digunderground/titan-bridge/hardware/ESP32 S3 N16R8 DevKitC-1 Module, for ESP32 S3 Development Boards with WiFi, Bluetooth 5.0 for Arduino, USB C with Antenna + IPEX.png

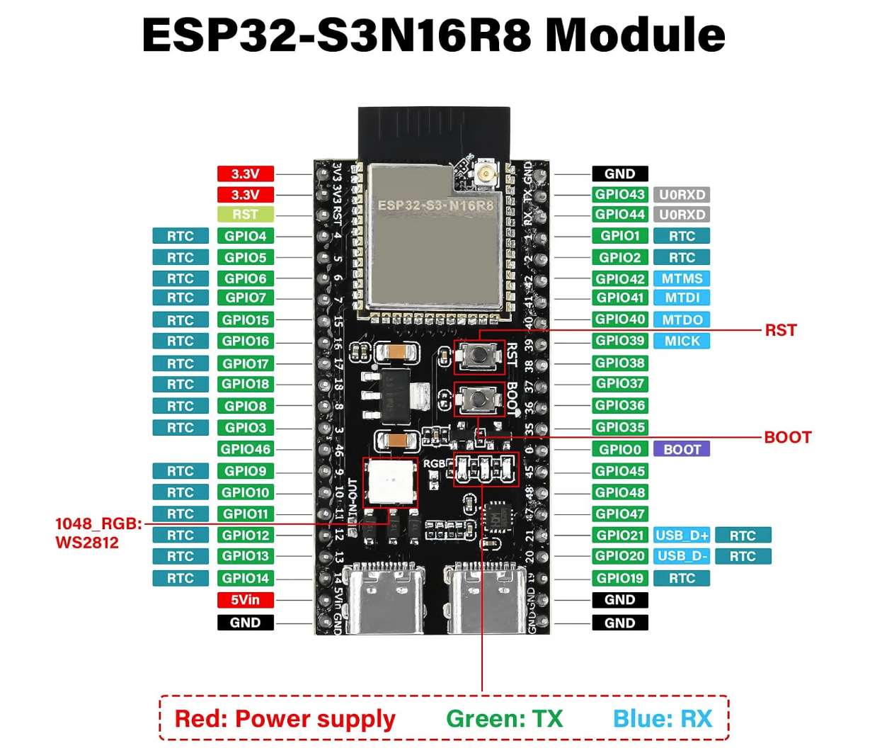
hardware/ESP32 S3 N16R8 DevKitC-1 Module, for ESP32 S3 Development Boards with WiFi, Bluetooth 5.0 for Arduino, USB C with Antenna + IPEX.png
