digunderground/titan-bridge/docs/06-command-reference.md

# XGIMI TITAN Noir — verified command reference

Transcribed from XGIMI's own command-set image (help centre article
`53406154382361`, attachment `53406327353497`, 2110×1253) and checked
byte-for-byte against the checksum rule. Where the source document is
internally inconsistent, that is called out rather than silently corrected.

## Link settings

| | |
|---|---|
| Enable | Settings → General → **Serial Port Control** = ON |
| Transport | USB-to-RS232 or USB-to-TTL adapter in a projector USB port |
| Baud | 115200 |
| Frame | 8 data bits, no parity, 1 stop bit |
| Flow control | none |

Both projector USB ports (one 3.0, one 2.0) are documented as accepting a
USB-to-RS232 adapter, which is what makes the two-channel architecture
possible.

## Acknowledgements — undocumented, measured 2026-09-05

XGIMI's command image shows no acknowledgement. The projector sends one for
every command it accepts:

```
2A 2A 02 <instruction | 0x80> <parameter echoed> <checksum>
```

```
TX 2A 2A 02 03 1B 20   filmmaker      ->  RX 2A 2A 02 83 1B A0
TX 2A 2A 02 05 07 0E   brightness 7   ->  RX 2A 2A 02 85 07 8E
TX 2A 2A 02 13 00 15   temp           ->  RX 2A 2A 02 93 00 95
```

**The ACK does not indicate support.** It was tempting to read it as one — an
unsupported command producing no ACK would make the undocumented parameter
space testable without watching the screen. It does not work: sweeping
instruction `0x01` produced an ACK for **every** parameter tried, including
`0x7F`, `0x80`, `0xC0` and `0xFE`, none of which can be real inputs.

So the ACK confirms the frame was received and parsed, and nothing more. It is
still useful — it proves the link is alive and that a command was well-formed —
but the only way to know whether a parameter *does* something remains watching
the screen.

A status postback (e.g. temperature) arrives **six times, ~50 ms apart**, after
the ACK.

## Key simulation — instruction 0x07, undocumented parameters

Swept one code at a time with visual confirmation, 2026-09-05. XGIMI documents
`0x08`-`0x15`; the range below it was unexplored.

| Param | Effect |
|---|---|
| `0x01`-`0x05`, `0x07` | acknowledged, **no visible effect** |
| **`0x06`** | **opens a black-and-white calibration / test pattern** |

`0x06` is a genuine find: a service screen with no button on the remote and no
mention in XGIMI's table. It exits with `back`.

**The remote's four shortcut keys are not in this range**, and may not be
exposed over serial at all. Assignable buttons backed by recorded macros are a
better route to the same outcome — more than four of them, with labels.

Sweeping further (`0x16`+) was deliberately stopped: the codes are sparse, and
the odds of finding another service screen outweigh the value of finding
another key. If it is ever resumed, do it **one code at a time with the screen
in view** — a seven-code batch identified only that "something in this range
does something", which is barely a result.

Note this also confirms, on a second instruction, that **an ACK says nothing
about whether a code is live**. Six of these acknowledged and did nothing.

## Frame format

```
2A 2A <length> <instruction> <parameters...> <checksum>

length   = 1 (the instruction byte) + number of parameter bytes
checksum = (length + instruction + all parameter bytes) & 0xFF
```

The header `2A 2A` is excluded from the checksum. Worked examples from XGIMI's
own table: HDMI1 is `2A2A 02 01 01 04` (0x02+0x01+0x01 = 0x04); standby wake is
`2A2A 07 09 77 61 6B 65 75 70 9D`, where the parameters spell `wakeup` in ASCII
and the bytes sum to 0x29D → 0x9D.

---

## Source select — instruction 0x01

| Function | Param | Full frame | Firmware name |
|---|---|---|---|
| HDMI1 | 01 | `2A2A 02 01 01 04` | `hdmi1` |
| HDMI2 | 02 | `2A2A 02 01 02 05` | `hdmi2` |
| USB | 14 | `2A2A 02 01 14 17` | `usbsrc` |
| HDMI3 — **not in the document, CONFIRMED REAL 2026-09-05** | 03 | `2A2A 02 01 03 06` | `hdmi3` |

The published table lists two HDMI inputs on a three-HDMI projector, which
suggests it was copied from the original two-input TITAN. `hdmi3` is included
in the firmware on that suspicion. Day 1 Test 4 settles it; if `03` does
nothing, `sweep 01 00 08` walks the whole space.

## Picture mode — instruction 0x03

**Measured 2026-09-06. Five of the seven documented modes do nothing.**

| Mode | Param | Frame | Name | Effect on this unit |
|---|---|---|---|---|
| Vivid | 00 | `2A2A 02 03 00 05` | `vivid` | **none** |
| Movie | 01 | `2A2A 02 03 01 06` | `movie` | **none** |
| IMAX Enhanced | 02 | `2A2A 02 03 02 07` | `imax` | **none** |
| Performance | 05 | `2A2A 02 03 05 0A` | `perf` | works |
| TV | 07 | `2A2A 02 03 07 0C` | `tvmode` | **none** |
| Sport | 09 | `2A2A 02 03 09 0E` | `sport` | **none** |
| Filmmaker | 1B | `2A2A 02 03 1B 20` | `filmmaker` | works |

Parameters 03, 04, 06, 08 and 0A–1A are undocumented and were swept: all ACK,
none change the mode.

Three things this establishes, none of them in the vendor document:

1. **Only `05` and `1B` do anything.** Every other parameter, documented or
   not, is accepted and discarded.
2. **The ACK proves receipt, not support and not effect.** A documented mode
   like `00` ACKs perfectly and leaves the picture untouched. This is the
   second independent refutation of "no ACK means unsupported" — that claim was
   already retracted once, and the converse fails too.
3. **Performance and Filmmaker are not in the on-screen mode list.** The remote
   offers Standard, Movie, Sports, ISF Day, ISF Night. So the serial parameters
   and the OSD are two different sets, and `05`/`1B` reach modes the remote
   cannot. There is no serial parameter for Standard.

Picture mode is **write-only**: changing it from the physical remote produces
no serial frame at all (verified over a full five-mode walk — the projector
sent nothing but its 10-second temperature poll), so the current mode cannot be
read back.

## Brightness — instruction 0x05

Levels 1–10 are parameters `01`–`0A`, checksums `08`–`11`.

| Level | Frame | Name |
|---|---|---|
| 1 | `2A2A 02 05 01 08` | `b1` |
| 5 | `2A2A 02 05 05 0C` | `b5` |
| 10 | `2A2A 02 05 0A 11` | `b10` |

There is **no brightness query**. The bridge's step-up/step-down keys track
their own index open-loop and resynchronise whenever an explicit `b1`–`b10` is
sent.

## Factory reset — instruction 0x06  ⚠

| Function | Param | Frame |
|---|---|---|
| Restore factory settings, **wiping apps** | 00 | `2A2A 02 06 00 08` |
| Restore factory settings, keeping apps | 01 | `2A2A 02 06 01 09` |

Neither is reachable by name in either firmware, and `sweep` refuses
instruction `06` outright. Send it by hand with `raw` if you ever actually
mean it.

## Simulated key press — instruction 0x07

This is the way into everything the serial set does not cover: it drives the
OSD blind. See `docs/05-menu-mapping-worksheet.md`.

| Key | Param | Frame | Name |
|---|---|---|---|
| Power | 00 | `2A2A 02 07 00 09` | `power` |
| Signal source / custom | 08 | `2A2A 02 07 08 11` | `source` |
| Up | 09 | `2A2A 02 07 09 12` | `up` |
| Down | 0A | `2A2A 02 07 0A 13` | `down` |
| Right | 0B | `2A2A 02 07 0B 14` | `right` |
| Left | 0C | `2A2A 02 07 0C 15` | `left` |
| OK | 0D | `2A2A 02 07 0D 16` | `ok` |
| Back | 0E | `2A2A 02 07 0E 17` | `back` |
| Setting | 0F | `2A2A 02 07 0F 18` | `setting` |
| Home | 10 | `2A2A 02 07 10 19` | `home` |
| Volume up | 11 | `2A2A 02 07 11 1A` | `volup` |
| Volume down | 12 | `2A2A 02 07 12 1B` | `voldn` |
| Auto focus | 13 | `2A2A 02 07 13 1C` | `autofocus` |
| Manual focus | 14 | `2A2A 02 07 14 1D` | `manfocus` |
| Mute | 15 | `2A2A 02 07 15 1E` | `mute` |

The **power key is a toggle, not a discrete off.** Measured 2026-09-06: it
raises a **15-second power-off countdown**, and that countdown **completes into
a shutdown on its own**. `OK` only short-circuits it.

**The power key is sometimes not acknowledged at all**, while an `OK` sent
900 ms later on the same wire is acknowledged in 16 ms — so it is the projector
refusing that specific frame, not a sick link. When that happens the key has
provably had no effect: the `OK` then confirms nothing and the projector stays
on. That is what makes resending it safe — there is no countdown standing that a
second press could cancel.

Power-off therefore **waits for the power key's own ACK** before sending `OK`,
resends the power key up to 3 times if the ACK does not arrive, and gives up
without sending `OK` rather than confirming a dialog that was never raised.

Two earlier attempts are recorded here as warnings. Waiting out the 15 s
countdown instead of confirming was deterministic but slower, and dropping a
`back` keypress in front of the power key — on a correlation from seven samples —
took power-off from intermittent to failing 10/10. Both replaced a working
sequence without measuring against it.

Because the key is a toggle, sending it to an **already-off** projector turns it
**on**. That is why a hub's "Power off" button could wake the unit. The bridge
now guards off in both power modes while never guarding on — `wake` is
idempotent, so guarding it only creates a "PowerOn does nothing" failure.

There is **no Menu key** here. The USB HID keyboard's Application/Menu key
(usage `0x65`) has no serial equivalent, which is the whole reason the HID
channel stays in the final design.

## Standby wake — instruction 0x09

```
2A2A 07 09 77 61 6B 65 75 70 9D          parameters = "wakeup" in ASCII
```

Conspicuously not a simulated key press. An ASCII payload on its own
instruction suggests a separate always-listening path in the projector's
firmware — which is exactly what you would want a wake command to be.

**`wake` is idempotent.** Sent to a projector that is already on, it does
nothing at all (measured 2026-09-06). This is what makes it safe to send
unconditionally, and it is why the on-path is never guarded.

### There is no discrete off — probed and ruled out

Because `0x09` is *string-keyed*, a symmetric off seemed plausible. Each of
these was sent to an awake projector:

| word | frame | result |
|---|---|---|
| `sleep` | `2A2A 06 09 73 6C 65 65 70 28` | ACK, no effect |
| `standby`  | `2A2A 08 09 73 74 61 6E 64 62 79 06` | ACK, no effect |
| `poweroff` | `2A2A 09 09 70 6F 77 65 72 6F 66 66 7A` | ACK, no effect |
| `shutdown` | `2A2A 09 09 73 68 75 74 64 6F 77 6E 8E` | ACK, no effect |

All four were acknowledged with the **payload echoed back verbatim** —
byte-for-byte the same ACK shape as the working `wakeup`. So for this
instruction the echo carries no signal whatsoever: a command that works and
four that do nothing are indistinguishable in the reply.

That matters beyond power. Echo inspection looked like the most promising way
to enumerate real commands without a camera (the UDS `requestOutOfRange`
trick). On `0x09` it does not work. Anything built on it must be validated
against a known-good/known-dead pair first.

## Screen blank — instruction 0x0D

| Function | Param | Frame | Name |
|---|---|---|---|
| Turn off the screen | 00 | `2A2A 02 0D 00 0F` | `blank` |
| Open screen | 01 | `2A2A 02 0D 01 10` | `unblank` |

## High refresh rate — instruction 0x0E

| Function | Param | Checksum in doc | Frame used | Name |
|---|---|---|---|---|
| Off | 00 | 10 | `2A2A 02 0E 00 10` | `hrroff` |
| Basics | 01 | 11 | `2A2A 02 0E 01 11` | `hrrbasic` |
| Extreme speed | **01** | **12** | `2A2A 02 0E 02 12` | `hrrmax` |

The document prints parameter `01` twice with two different checksums. `0x12`
is only reachable if the parameter is `02` (0x02+0x0E+0x02), and a distinct
mode needs a distinct parameter. **The firmware follows the checksum.** Verify
on hardware and, if `02` does nothing, try `raw 2A2A020E0111` and watch whether
the mode differs from `hrrbasic`.

## Temperature — instruction 0x13

Request:

```
2A2A 02 13 00 15                          firmware name: temp
```

Postbacks arrive **unprompted** as well as in reply:

| Meaning | Frame |
|---|---|
| Normal | `2A2A 03 13 01 00 17` |
| High temperature warning | `2A2A 03 13 01 01 18` |
| High temperature shutdown warning | `2A2A 03 13 01 02 19` |
| Low temperature shutdown warning | `2A2A 03 13 01 03 1A` |
| Sensor abnormal (open/short circuit) | `2A2A 03 13 01 04 1B` |

**This is the only feedback channel the projector has** — and it does not
report power state. The projector's serial daemon runs in standby and answers
the temperature probe identically either way, so a reply means the *link* is
alive, not that the projector is on. An earlier version of this document said
the opposite; that was wrong, and `TEMP_PROBE_INDICATES_POWER 0` in `config.h`
encodes the correction. Power state is assumed and user-correctable, because
nothing on the wire can confirm it.

`0x13` is **not** a general query family. Parameters `01`–`20` were swept
2026-09-06: every one is ACKed, none returns a data frame. `00` is the only
parameter that answers. There is no readback for input, picture mode, volume
or power — the protocol is write-only apart from temperature.

Log the postbacks — a high-temperature warning is the one thing here worth an
alert.

---

## USB keyboard map (HID channel)

XGIMI documents a USB keyboard as a supported input device. These are the
usages the bridge sends.

| Key | HID usage | Function | Serial equivalent |
|---|---|---|---|
| Arrows | 0x4F–0x52 | Navigation | yes |
| Enter | 0x28 | OK | yes |
| Esc | 0x29 | Back | yes |
| Home | 0x4A | Open settings | yes |
| Page Up / Down | 0x4B / 0x4E | Volume | yes |
| Keypad + / − | 0x57 / 0x56 | Manual focus | partial (`manfocus` only) |
| **Menu / Application** | **0x65** | Contextual menu | **no** |

## TITAN IR codeset (NEC, header 0x21DE)

Published for the **original** TITAN. The Noir series dropped the rear IR
receiver, the 3.5 mm REMOTE port and the IR remote, so this is only relevant if
Day 1 Test 6 finds a live receiver anyway.

| Key | Code | Key | Code | Key | Code |
|---|---|---|---|---|---|
| Power | 4D | Home | 1A | Menu | 45 |
| Back | 42 | Source | 4F | Up | 0B |
| Down | 0E | Left | 10 | Right | 11 |
| OK | 0D | Settings | 48 | Settings (after OSD) | 12 |
| OSD | 19 | Vol+ | 18 | Vol− | 17 |
| Focus+ | 1C | Focus− | 1D | Menu rotation | 1E |
| Keystone | 1F | Lens shift & zoom | 20 | HDMI1 | 24 |
| HDMI2 | 25 | USB | 26 | Picture standard | 41 |
| Movie | 44 | Vivid | 4A | TV | 4B |

The p2 firmware **receives** IR rather than sending it, and decodes any NEC
remote — so this table matters for Test 6 and nothing else.

---

## What is not here

No serial command exists for 3D mode, lens memory, iris level, keystone or lens
shift. Instruction `0x07` is the way in: drive the OSD with counted key presses
from a known anchor. `docs/05-menu-mapping-worksheet.md` is how you record
those paths so they survive a firmware update.

## After every projector firmware update

1. Re-pull the help-centre article and **diff the command-table image**. XGIMI
   have already revised it once. New instruction bytes are the cheapest
   capability you will ever gain, and lens memory is promised in a future OTA.
2. Re-run Test 5 — standby power behaviour can change.
3. Re-verify one macro per menu branch before trusting the rest.
4. Note the new version against the mapping worksheet.
