digunderground/titan-bridge/hardware/DSD TECH SH-U09G USB to TTL Serial Cable Built-in FTDI FT232RL IC.png

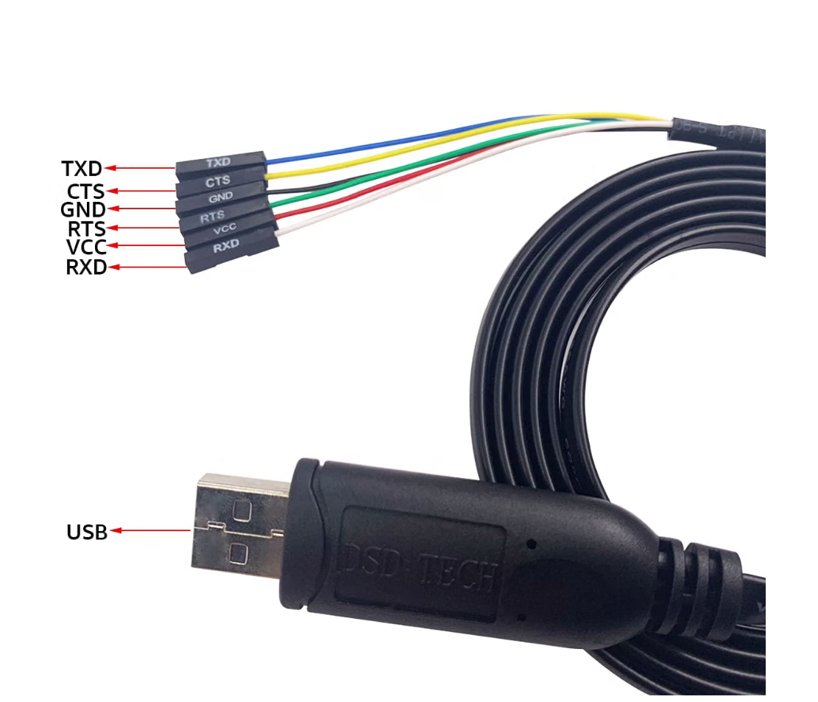
hardware/DSD TECH SH-U09G USB to TTL Serial Cable Built-in FTDI FT232RL IC.png
