digunderground/titan-bridge/hardware/wiring.png

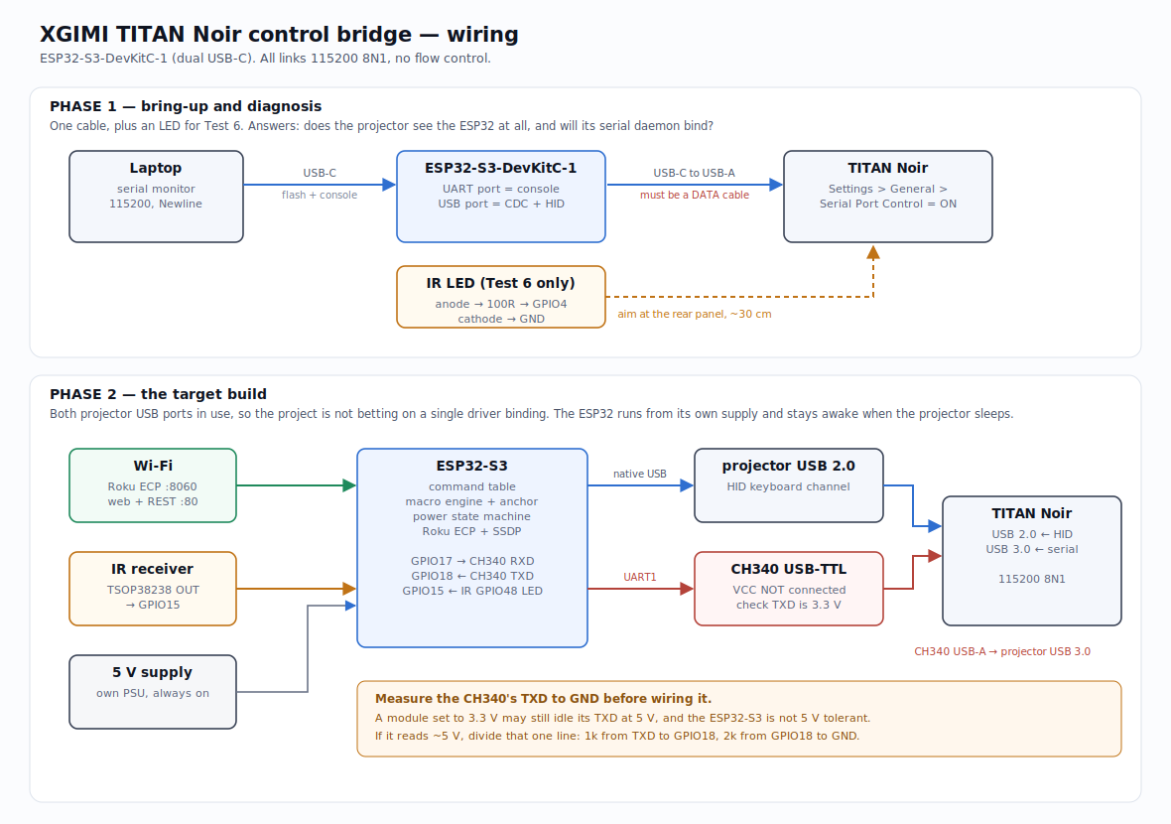
hardware/wiring.png
