digunderground/titan-bridge/logs/TEST-LOG.md

# Test log

Paste console transcripts here. Every line the p1 sketch prints is timestamped
in `[seconds.milliseconds]` form for exactly this reason — the gaps between
lines are the evidence, particularly around standby.

---

## Pre-Day-1 findings — 2026-09-04

Established before any bridge hardware was flashed, with a USB keyboard and the
projector's own menu.

| Finding | Result | How |
|---|---|---|
| Serial Port Control exists in this firmware | **yes, enabled** | Settings → General |
| Projector's USB host accepts an HID keyboard | **yes** | plugged in a plain USB keyboard |
| OSD responds to keyboard navigation | **yes, "perfectly"** | arrow keys / Enter moved the menu |

**Why it matters.** Test 1 asks whether the projector will enumerate and obey a
USB HID device. A retail keyboard answers the host-stack half of that question
outright: the port enumerates, the HID driver loads, and the OSD consumes key
events. What remains unproven is only whether the **ESP32-S3's TinyUSB HID**
is accepted on the same terms — a much narrower risk than "does HID work at
all", and no longer on the critical path, since menu navigation runs over
serial instruction `0x07` and HID is needed only for Menu and manual focus.

It also means the menu tree can be mapped by hand, tonight, with the keyboard —
see `docs/10-hid-key-probe.md`. That is Sunday's job, done at typing speed
instead of one 250 ms macro step at a time.

**Still unknown:** everything on the serial side. Test 2 (does the daemon bind)
is the next question, and it is the one the whole project turns on.

---

## Bridge bring-up — 2026-09-04, no projector attached

HiLetgo ESP-WROOM-32, `titan_bridge_p2` built with `BOARD=3` (`CH_UART0`), so
the projector link runs through the board's **own onboard USB-serial chip**.
Laptop on the far end of that link running `tools/fake_projector.py`, standing
in for the projector.

```
[0.422] link up: UART0/onboard-bridge @ 115200 8N1
[5.325] TX 2A 2A 02 13 00 15
[5.403] RX 2A 2A 03 13 01 00 17  temp=normal
[6.830] power state -> awake
```

`/api/status`: `power=awake  temp=normal  rx=14  lastrx="2A 2A 03 13 01 00 17"`
Wi-Fi `<your-ssid>` → 10.0.0.215, rssi −55 dBm. mDNS and Roku ECP both up
(`TB9E9C8544` on :8060).

| Layer | Result |
|---|---|
| Board boots, poll loop at `POLL_INTERVAL_MS` | ✅ 10.0 s, measured |
| 2A2A frame builder + checksum | ✅ `2A 2A 02 13 00 15`, `(2+0x13+0x00)&0xFF = 0x15` |
| TX through the onboard bridge chip | ✅ |
| RX framing and decode | ✅ `temp=normal` |
| Power state machine → awake | ✅ on reply |
| Power state machine → asleep | ✅ at 29.0 s, after `POLL_MISSES_TO_SLEEP` = 3 unanswered |
| Wi-Fi, mDNS, REST API, Roku ECP | ✅ |
| ROM boot chatter poisoning the stream | ✅ harmless — resynced away by the `2A 2A` search |

**Everything in the chain is now proven except the projector.** Test 2 is the
single remaining unknown: whether its serial daemon binds the bridge chip.

---

## Test 1 — HID via the bridge: **PASSED** — 2026-09-05

**The projector is under control.** ESP32-S3-DevKitC-1, `titan_bridge_p2` built
with `BOARD=1`, native USB port straight into a projector USB port, board
powered from that same port, commanded entirely over Wi-Fi from another room.

```
[69.634] key channel -> hid
[71.703] HID home (0x4A)      -> OSD opened
[74.779] HID down (0x51)      -> selection moved
[76.857] HID down (0x51)
[79.026] HID down (0x51)
[81.116] HID up (0x52)
[83.186] HID menu (0x65)
```

Observed on screen: **the menu opened and the selection moved.**

Build that did it:

```
esp32:esp32:esp32s3:USBMode=default,CDCOnBoot=default,FlashSize=16M,PartitionScheme=min_spiffs
-DBOARD=1
```

`USBMode=default` (USB-OTG/TinyUSB) is not optional — under the `hwcdc`
default the HID interface never enumerates and none of this happens.

### What this settles

The plan had serial as the primary channel and HID as a gap-filler for Menu
and manual focus. **That is now inverted.** Serial does not exist on this
projector; HID does, and it carries the navigation the macro engine needs.
`keychan hid` makes that the routing for `anchor` and every `k:` step, so the
counted paths in `docs/05` and `docs/10` work unchanged.

The native USB port also enumerates as `Titan Bridge` / `DIY` (VID 0x303A).

### Still not working, and now confirmed twice

`cdc=false` throughout: the projector never opened the native CDC endpoint
either. Test 2 has now failed in **both** its forms — native CDC on an S3, and
a CP2102 USB-serial adapter. Whatever XGIMI's Serial Port Control does on this
model, it does not bind a USB device.

---

## Serial capability, confirmed on screen — 2026-09-05

Everything below was watched on the projector, not inferred from an ACK. That
distinction matters: the ACK acknowledges receipt only, and acknowledged every
parameter tried including `0xFE`.

| Test | Result |
|---|---|
| Serial `wake` (`2A2A 07 09 "wakeup" 9D`) from standby | **works — turns the projector on** |
| Serial navigation, instruction `0x07` | **works — OSD opened, cursor moved three times, exited clean** |
| **`hdmi3` — the undocumented third input** | **REAL — switches to HDMI 3, twice, in both directions** |

### Test 4 answered: HDMI3 exists

`docs/06` records that XGIMI's table lists HDMI1, HDMI2 and USB only, on a
projector with three HDMI inputs, and the plan called that "a document copied
from the two-input original TITAN". It was. Parameter `0x03` on instruction
`0x01` selects the third input.

### The temperature probe is NOT a power indicator — measured

The plan's liveness model — "a reply means awake, silence means asleep" — is
**false on this projector**. With it switched off, temperature replies kept
arriving at exactly the same rate:

```
t=10s  power=awake  temp=normal  rx=2483
t=80s  power=awake  temp=normal  rx=2819     <- 48 bytes/10s, unchanged
```

The serial daemon runs in standby. A reply proves the *link* works and says
nothing about power.

This retracts the "verified power state" claimed when serial first came up.
`powerobserved` is now true only for a genuine USB bus transition — which this
projector does not produce either. **So power state on this model is always
assumed**, whichever channel is in use, and the UI says so rather than
displaying a confident guess.

`TEMP_PROBE_INDICATES_POWER` in `config.h` re-enables the old inference for a
projector that is actually shown to go quiet in standby.

### Instruction 0x07 sweep — one undocumented key found

`0x01`-`0x05` and `0x07`: acknowledged, no visible effect.
**`0x06`: opens a black-and-white calibration / test pattern.** Undocumented,
no button on the remote, exits with `back`.

The four shortcut keys on the physical remote are **not** in this range.

Method note: the first attempt swept all seven codes in one pass with 5 s gaps,
which established only that *something* in the range did *something* — the log
ring had rotated by the time it was reported. Redone one code at a time with
confirmation between each, which identified `0x06` immediately.

### Commands sent in standby are honoured — input can be pre-selected

The projector was left on HDMI3 and switched off. With it off, `hdmi1` was sent
(ACKed), then `wake` (ACKed). **It powered on displaying HDMI1.**

So the serial daemon does not merely answer queries in standby — it acts on
commands. A "movie night" macro can therefore be a single sequence that wakes
the projector *straight onto* the right input, with no menu walk and no waiting
for the OSD to settle:

```
s:hdmi1; d200; s:wake
```

Whether the projector executes the command while asleep or queues it and
applies it at wake is not observable from outside, and does not matter.

### `wake` is a real discrete power-on

Unlike the HID power key (`0x66`), which is a toggle, the documented serial
`wake` command turns the projector **on** from standby without ambiguity. That
is strictly better for automation: no assumed state, nothing to drift.

Power **off** still has no verified discrete equivalent — the serial power key
is a key simulation with a confirmation dialog behind it.

### Serial navigation is the more robust channel

Instruction `0x07` genuinely drives the OSD, so macros can run on serial rather
than depending on the ESP32's native USB port — which means they survive
reflashing and unplugging that port. HID remains necessary only for keys serial
has no equivalent for.

---

## Test 2 — serial binding: **PASSED with FTDI** — 2026-09-05

`ftdi_sio` is in the projector's kernel. Third driver class tried, and the one
that binds.

DSD TECH SH-U09G (FT232RL, genuine — vendor "FTDI", unique serial `BH001L1L`),
TTL level 3.3 V, wired TXD→GPIO18, RXD→GPIO17, GND→GND, VCC left unconnected.
Dual path per plan §5: ESP32-S3 native USB on the projector's USB 3.0 port
carrying HID, the FTDI cable on USB 2.0 carrying serial.

```
[83.097] TX 2A 2A 02 13 00 15
[83.119] RX 2A 2A 02 93 00 95      <- ACK
[83.131] RX 2A 2A 03 13 01 00 17   temp=normal
```

| Chip | Driver | Binds? |
|---|---|---|
| CP2102 | `cp210x` | no |
| CH340G | `ch341` | no |
| **FT232RL** | **`ftdi_sio`** | **YES** |

The wiring was proven on the bench first each time — laptop standing in for
the projector, frames out and replies in — so every failure was unambiguously
the projector's driver support and not the rig.

### Undocumented: every command is acknowledged

XGIMI's published command image documents no acknowledgement at all. The
projector sends one, and it is more useful than the temperature probe:

```
TX 2A 2A 02 03 1B 20    filmmaker      ->  RX 2A 2A 02 83 1B A0
TX 2A 2A 02 05 07 0E    brightness 7   ->  RX 2A 2A 02 85 07 8E
TX 2A 2A 02 13 00 15    temp           ->  RX 2A 2A 02 93 00 95
```

**Format: `2A 2A 02 <instruction | 0x80> <parameter echoed> <checksum>`.**

**It does not indicate support — tested and disproved the same day.** The
appealing reading was that an unsupported command would go unacknowledged,
making the undocumented parameter space testable without watching the screen.
A sweep of instruction `0x01` ACKed **every** parameter tried, including
`0x7F`, `0x80`, `0xC0` and `0xFE`. The ACK means "received and parsed", full
stop.

`hdmi3` therefore remains **unproven**. It ACKs, but so does `0xFE`. Only the
screen can answer it.

### Also undocumented: status is repeated

A status postback arrives **six times, ~50 ms apart**, after the ACK. Harmless,
but it floods a 60-line log ring in about a minute, so the firmware now
collapses consecutive identical frames.

---

## SofaBaton X2 — **WORKING** — 2026-09-05

The hub drives the projector. Power, navigation and macros all arrive over
Roku ECP and go out over USB HID.

### What made discovery work

Not what the plan assumed. Two independent blockers, both invisible from
outside the device:

1. **SSDP reception died seconds after every subscribe.** Announcements were
   sent on the same `WiFiUDP` object that was joined to the multicast group,
   and on this stack sending reconfigures the socket and drops membership —
   so every NOTIFY silently deafened us. Split into separate RX and TX sockets.
2. **`/query/apps` returned an empty list** when no user macros existed.
   SofaBaton validates that XML before listing a device.

And then the actual mechanism: **the app listens for `ssdp:alive`** rather than
relying on its own M-SEARCH reaching us. Inbound multicast on this network was
unreliable — the hub's searches never arrived at all — but outbound
announcements were heard fine. Dropping the announce interval from 60 s to
10 s is what made it appear:

```
[18.681] ECP root <- 10.0.0.124        <- the phone, unprompted
```

### The power buttons "reversed"

They were not. The ECP mapping was correct throughout; the bridge's *assumed*
power state was exactly one state out. Because `0x66` is a toggle, each press
flipped both the belief and the projector, so the inversion was
self-perpetuating and could never correct itself — which reads convincingly as
crossed wires.

Cause: earlier testing fired `0x66` through `/api/hidraw`, which bypasses the
power state machine, so those toggles changed the projector without the bridge
knowing. One resync fixed it.

**Drift only comes from changes the bridge does not make** — the physical
remote, or a raw HID call. The tell is both buttons appearing to do the
opposite of their label. Settings → Power state → "It's on"/"It's off".

A working serial link would end this permanently: the temperature probe makes
power verified rather than assumed, and drift becomes impossible.

---

## Test 2 — CDC/serial binding: **FAILED** — 2026-09-04

The projector does not bind a CP2102 as a serial device. Not a wiring problem,
not a firmware problem, not a cable.

### What was ruled out, and how

| Suspect | Ruled out by |
|---|---|
| Bridge firmware / frame format | `fake_projector.py` round-trips the same build: TX, RX, decode, power state all correct |
| Cable (charge-only) | Board enumerated as `/dev/cu.usbserial-0001` **through the projector cable** on the laptop |
| Wrong chip class | It is a **CP2102**, Silicon Labs `0x10C4`, serial `0001` — one of the three drivers (`ch341`/`cp210x`/`pl2303`) the plan expects |
| Serial Port Control off | On, verified on-screen |
| Daemon not started at boot | Full mains power-cycle, retested |
| Wrong USB port | Both 3.0 and 2.0 tried |
| Projector USB port dead | A USB **keyboard** on the same port drives the OSD perfectly |
| ID addressing | 7 header variants — `**`, `A0`, `*0`, `A*`, `A\0`, and the address before/after the header — all silent |

### The decisive observation

`uptime` climbs monotonically the entire time the board is on the projector. A
host opening a CP2102 asserts DTR, and on any ESP32 dev board that resets the
MCU — it is exactly how `esptool` reboots it (`Hard resetting via RTS pin`).
**The projector never asserted DTR, so it never opened the port.** This is not
a daemon that binds and ignores us; it is a daemon that never binds.

### Why `rx = 0` is stronger evidence than it looks

`rxBytes++` is the first statement in `rxByte()`, before the `2A 2A` header
check (`titan.cpp`). The counter therefore counts **every byte that arrives on
the wire**, whatever its header, framing or validity.

So `rx = 0` does not mean "replies arrived that we could not parse" — the
obvious worry once the projector turns out to have ID addressing. It means no
byte was ever received. The receive line is electrically silent.

Diagnostic to remember for the CH340/PL2303 attempts: if `rx` climbs while the
log shows no `RX` lines, that is bytes arriving that never frame up — which
*would* mean an unexpected header, and addressing would be back on the table.
`rx` static at 0 rules that out.

### Serial Port Control menu, as found

```
Serial Port Control Switch   ON
Serial Port ID Group          A
Serial Port ID Number         0
Serial Port Response (Group) ON
Serial Port Response (All)   ON
```

`docs/06-command-reference.md` was transcribed from XGIMI's published command
image, and **that image documents no ID field at all**. The firmware exposes
group/ID addressing the protocol document does not describe.

### The leading explanation: a missing kernel driver

An earlier theory here — that the Serial Port Control page was vestigial UI
inherited from a commercial sibling with a real DB9 — is **wrong, and is
retracted**. Checked against sources:

- XGIMI's own article is titled *"How to use the RS232 on the TITAN?"* and
  describes only enabling the setting and configuring 115200 8N1. It is real.
- The TITAN Noir has **no DB9**. Its ports are 2×HDMI, 2×USB, RJ45, 3.5 mm.
- Third-party reporting states the projector "will recognize an RS232/USB
  adapter when connected to one of its USB ports and then offer remote control
  via the serial port."

So the USB-adapter premise this project is built on is correct, and the feature
is genuinely implemented. What is far more likely is that **the projector's
kernel does not carry `cp210x`.**

Embedded Linux builds ship a subset of the USB-serial drivers. If `cp210x` is
absent, a CP2102 never becomes a `/dev/ttyUSB*` at all — so nothing opens it,
nothing asserts DTR, and the receive line stays electrically silent. Every
observation follows from that one fact, and it is consistent with the DTR
evidence rather than in tension with it.

This makes the adapters on order the decisive test, not a long shot. `ftdi_sio`
and `pl2303` are the most commonly bundled drivers in SoC vendor kernels, with
`ch341` close behind — and a **genuine FTDI** is the single likeliest to work.

### The ID settings are real, and need no change

Group + ID addressing is an RS232 daisy-chain feature for multi-projector
installs, and its presence is evidence the protocol was designed with
addressing that XGIMI's published command image simply does not document. The
`2A 2A` header is ASCII `**` — two wildcards, i.e. the broadcast form of an
addressed protocol.

`Group A / ID 0` with **Response (Group)** and **Response (All)** both ON is
already the most permissive configuration available. Nothing to change, and the
bridge implements no addressing to match it against.

### CH340 (`ch341`) — also fails, 2026-09-05

Dual path, exactly as plan §5 describes: ESP32-S3 native USB on the projector's
USB 3.0 port carrying HID, a CH340G on USB 2.0 carrying serial, its TTL side on
the bridge's UART1 (GPIO17/18, jumper on 3V3).

The wiring was proven first with the laptop standing in for the projector —
frames out, replies in, `temp=normal`, **0 bytes discarded as non-frame**. So
the adapter, the levels, the crossover and the UART1 channel are all known
good. Moved to the projector: `tx` climbing, `rx = 0`, indefinitely.

| Chip | Driver | Binds? |
|---|---|---|
| CP2102 | `cp210x` | no |
| CH340G | `ch341` | **no** |
| PL2303 | `pl2303` | untested |
| FT232RL | `ftdi_sio` | untested |

Two driver classes down. `ftdi_sio` is the one most commonly bundled in SoC
vendor kernels, so the FTDI adapters are the strongest remaining candidates —
and if they fail too, this projector does not bind USB-serial devices at all
and the serial channel does not exist on this model, whatever the
documentation implies.

None of this blocks anything: HID carries the whole product.

---

## Test 5 — standby behaviour: **ports stay powered** — 2026-09-04

Measured, not impression. The bridge was plugged into a projector USB port with
**no other power source**, and the projector was switched off. It stayed up:

```
uptime=355s  power=asleep  tx=42  rx=0
uptime=361s  power=asleep  tx=42  rx=0
uptime=367s  power=asleep  tx=43  rx=0
```

Wi-Fi held, uptime climbed straight through the power-off, no reboot.

**The USB ports remain powered in standby.** Distinguish this from mains-off,
where nothing survives — an earlier impression that the ports died was wrong.

### What it changes

`USB_DEAD_IN_STANDBY` stays **0**. The bridge survives standby, so it is still
there to wake the projector — which is the whole premise of plan §5's "power
the ESP32 from its own supply" requirement. That requirement is now a
convenience rather than a necessity, though a separate supply is still better
practice than depending on the projector's rail.

### The open question this creates

The port is alive in standby, but **can anything we send actually wake it?**

- Serial `wakeup` — unavailable, Test 2 failed on this model.
- **HID keypress — untested, and now the single most valuable experiment
  left.** A USB keyboard already drives the OSD when the projector is awake.
  If a keypress also wakes it from standby, there is discrete power-on with no
  smart plug, no HDMI-CEC, and no serial.

Test: leave a USB keyboard plugged in, put the projector in standby, press
keys. Anything that wakes it is the power-on path.

```
Date:               ____________________
Projector firmware: ____________________
Bridge firmware:    titan_bridge_p1
Projector USB port: [ ] 3.0  [ ] 2.0
Adapter:            [ ] none (native CDC)  [ ] CH340  [ ] CP2102  [ ] FTDI  [ ] DB9+MAX3232
```

## Results summary

| Test | Result | Note |
|---|---|---|
| 0 — bench sanity | | |
| 1 — USB enumeration (HID) | | |
| 2 — CDC serial binding | | |
| 3 — command sweep | | |
| 4 — HDMI3 / undocumented params | | |
| 5 — standby behaviour | | |
| 6 — IR receiver | | |

**Verdict:** ______________________________________________

**Channel chosen:** [ ] native CDC   [ ] UART1 + dongle   [ ] both

---

## Transcript

```
(paste here)
```

---

## Undocumented findings

Anything the published table does not have. These are the valuable bits — new
instruction bytes are the cheapest capability this project will ever gain.

| Instruction | Parameter | Observed effect | Frame |
|---|---|---|---|
| | | | |

## 2026-09-06 — picture mode (instruction 0x03): retraction and re-baseline

**Retracted.** I reported that parameter `0x03` selects "Standard". It does not.
Before the first probe the user had already said *"its on 'standard' nnow"* — the
projector was in Standard when the test started. I sent `0x00`, then `0x03`, saw
Standard, and credited it to the command. It was the pre-existing state. Every
conclusion drawn from that run is void.

**Measured instead** (user tested each documented mode from the web UI):

| param | XGIMI's name | takes effect |
|---|---|---|
| 0x00  | Vivid | no  |
| 0x01  | Movie | no  |
| 0x02  | IMAX | no  |
| 0x05  | Performance  | **yes** |
| 0x07  | TV | no  |
| 0x09  | Sport | no  |
| 0x1B  | Filmmaker | **yes** |
| 0x03, 0x04, 0x06, 0x08, 0x0A–0x1A | undocumented | no |

Only `0x05` and `0x1B` change the mode. All of the others ACK and do nothing,
which is a second, independent confirmation that **an ACK means receipt, not
support and not effect** — a documented parameter can ACK cleanly and still be
ignored. Absence of an ACK is evidence; presence of one is not.

Whether a "Standard" parameter exists is still open. Next step is to capture
what the projector emits (if anything) when the mode is changed from the
physical remote, which would give the real parameter values rather than
XGIMI's table.

**Tooling fix made in the same session:** `frameComplete()` collapsed
consecutive identical frames, including ACKs. Probing means sending the same
frame twice and watching whether it is still answered, so the collapse made the
second send look like a failure. ACKs are now exempt from the collapse.

### Query-family sweep — instruction 0x13, params 0x00–0x20

Ran after establishing that picture mode never reports itself, on the theory
that `0x13` might be a *query* instruction with `0x01` selecting temperature
(the poll is `2A 2A 02 13 00 15` → `2A 2A 03 13 01 00 17`). If some other
parameter read back power or input, the bridge could stop guessing at power
state.

It does not. All 33 parameters ACK; **only `00` returns a data frame.** Across
the whole sweep the only RX frames in the log were the 10-second temperature
polls. `0x13` reads temperature and nothing else.

So the protocol is write-only apart from temperature, and temperature does not
indicate power (the daemon answers in standby). Assumed-and-correctable power
state stays the right design; there is no wire evidence available to replace it.

### Picture mode is write-only

Full five-mode walk on the physical remote (Standard → Movie → Sports → ISF Day
→ ISF Night), ~3 s apart, with poll traffic logged. The projector emitted
**nothing**. 1200 bytes received during the capture, all of it the temperature
poll. Changing a setting from the remote produces no serial frame.

Also worth recording: that OSD list — Standard, Movie, Sports, ISF Day, ISF
Night — shares only "Movie" with XGIMI's serial table, and neither Performance
nor Filmmaker appears in it, though both work over serial. The serial parameter
set and the on-screen menu are two different worlds.

## 2026-09-06 — the hub's "power off" was turning the projector ON

Reported: pressing **Turn off** or **Power off** on the SofaBaton while the
projector was already off switched it **on**.

### Both labels are the same command

The hub sends `/keypress/PowerOff` for both. There is no "turn off" vs "power
off" distinction — a question that had been open since 2026-09-05. Confirmed
from the ECP log: three presses, three identical `PowerOff` requests from
10.0.0.118.

### Root cause 1 — off is a toggle and was unguarded

`titanPowerOff()` skipped its believed-state check whenever `powerObey` was
set, and obey is the mode in use. So an off sent to an off projector fired the
power key, which is a **toggle**, and turned it on.

Fixed by making the guard unconditional for off while leaving on unguarded.
The asymmetry is deliberate: `wake` is idempotent (verified — sending it to an
awake projector does nothing), so guarding on only ever produces "PowerOn does
nothing". Off is a toggle, so the worst case for guarding it is "nothing
happened" versus "the projector switched on and stayed on".

### Root cause 2 — the off sequence was racing a dialog it could not see

The power key raises a **15-second power-off countdown**. The bridge pressed
`OK` 900 ms later (`POWEROFF_CONFIRM_MS`) to short-circuit it.

Measured: the dialog does not reliably exist at 900 ms. When it did not, the
`OK` landed on nothing — and the countdown then ran unattended.

**The countdown completes into a shutdown by itself.** So the outcome depended
on a race nobody knew was running, and the bridge recorded "off" either way.
Once off was guarded (fix 1), a lost race desynced the assumed state and
silently suppressed every subsequent press — the user had to open Settings and
declare "it's on" before the remote would work again. Fix 1 made fix 2's
absence much worse; they had to ship together.

Power-off is now a single press followed by waiting the countdown out. Slower
by ~15 s, and free of the race. Operator's call, and the right one: *"15
seconds till off is never an issue."*

### Root cause 3 — `/api/raw` desynced the assumed state

Raw sends bypassed `titanSendNamed()`, so a power key sent for diagnostics did
not update belief. This bit during the investigation itself: the app read
"on (assumed)" with the projector off. `/api/raw` now updates the assumed state
for the power key and `wake`, and logs the actual bytes rather than
`TX raw 6 bytes` — which also closes a blind spot that would have made the
planned command sweeps unreadable.

### No discrete off exists

`0x09` is string-keyed (`"wakeup"`), so `sleep`, `standby`, `poweroff` and
`shutdown` were each sent to an awake projector. All four ACKed with the
payload echoed verbatim, identical in shape to the working `wakeup`, and none
did anything. See `docs/06-command-reference.md`.

This is the **fifth** independent demonstration that an ACK proves receipt and
nothing else — and it also refutes, for this instruction, the parameter-echo
idea that the mapping plan lists as its most promising camera-free experiment:
one working command and four dead ones are byte-identical in the reply.

## 2026-09-07 — the spontaneous power-ons were the SofaBaton

Captured at last, because the persistent event log survived the reboot that had
erased every previous attempt:

```
[18.279] ECP /keypress/PowerOn <- 10.0.0.118
[18.290] TX 2A 2A 07 09 77 61 6B 65 75 70 9D
```

Sixteen seconds after the bridge joined Wi-Fi, nobody touching anything. The
bridge announces `ssdp:alive` on boot; the hub sees its "Roku" reappear and
re-asserts the power state it believes the device should be in.

Fixed by making SSDP announcing opt-in and ignoring ECP power commands for 45 s
after boot. A following boot showed **zero** hub traffic past 60 s, where the
previous boot had `PowerOn` at 18 s.

### Retractions this cost

- **"Nothing was sent, tx is exactly one poll per 10 s."** The polls were the
  only traffic *and* the only thing excluded from the log. Silence in that log
  was never evidence of anything.
- **"USB re-enumeration is ruled out."** Tested with a soft reset, which keeps
  VBUS up — not the same event as a cold attach. Stated far more confidently
  than the test supported.
- **"The last flash bricked the board."** Boot #4 wrote its own event entry, so
  it booted fine and simply never reached the LAN. The USB recovery flash was
  unnecessary.

### Power-off, and two self-inflicted regressions

The day-one sequence — `power`, 900 ms, `OK` — was reported working. It was then
replaced twice without measuring against that baseline: first by waiting out the
15 s countdown, then by prefixing a `back` keypress on a seven-sample
correlation. The second took power-off from intermittent to failing 10/10.

Restored, then improved with evidence rather than theory: the power key is
sometimes **not acknowledged at all** while an `OK` 900 ms later is acknowledged
in 16 ms. An unacknowledged power key provably did nothing, so the sequence now
waits for that ACK, resends up to 3 times, and refuses to send `OK` into a
dialog that was never raised. Verified non-regressing (ACK in 35 ms, first try);
the retry path itself is **not yet exercised** and remains unproven.

### 2026-09-07, later — 0.8.2 shipped with a power regression

**The 0.8.2 release contains a bug.** Power-on from the hub did nothing:

```
[140.220] power on: HID power key
[140.250] HID power (0x66)
```

It routed power over **HID**, which is not wired to the projector in the
serial-only configuration, and then recorded "on" because a HID toggle assumes
success.

Chain: the poll was gated while the projector was believed off → no frames were
ever received → `everFrame` stayed false → `hidPowerPath()` treats "the serial
link has never spoken" as "use HID" → power silently left over the wrong
channel.

The poll gate was added to test the theory that the poll woke the projector.
That theory was **disproven the same day** (the hub was re-asserting PowerOn),
and the gate should have been removed when the real cause landed instead of
being left in the build. Reverted; the fallback now logs itself instead of
switching silently.

**Process failure worth naming:** the release was tagged after verifying a
power-*off*, without testing a full on/off cycle. Test the cycle before tagging.

### 2026-09-07 — power-off solved: the confirm was missing

`power` (`0x07 00`) raises a shutdown dialog. **That dialog must be confirmed
with `OK` (`0x07 0D`). It does not time out into a shutdown.**

Found by comparing two attempts in one capture, on firmware that sends no `OK`
at all:

```
[57.683] TX 07 00   power     ← worked
[60.084] TX 07 0D   ok        ← sent BY THE OPERATOR, 2.4 s later
...
[234.951] TX 07 00  power     ← failed, no OK followed
```

Byte-identical commands; the only difference was the operator's confirm. Their
working procedure had a step nobody had written down.

**Confirm delay is now 2500 ms**, measured from the successful attempt. The
original 900 ms was a guess sitting on the edge of the dialog rendering — the
best explanation for why power-off was *intermittent* from the very beginning
rather than simply broken.

### Everything that was tried instead, and why each was wrong

| attempt | outcome |
|---|---|
| Verify-then-retry (original) | `probeAnswered()` always true, so it double-pressed power and turned the projector back on |
| Remove `OK`, wait out the countdown | The countdown does not self-complete. Based on one unverified operator remark. |
| `back` nudge before power | Failed 10/10. Added in the same build as the `OK` removal, so neither could be evaluated. |
| `setting`+`back`+`back` OSD prelude | Worked once, failed once on identical fully-ACKed frames. A correlation, not a mechanism. |
| ACK-wait + retransmit | Correct and kept — but it addressed frame loss, which was never the main failure. |

**The lesson is not about the protocol.** Four rewrites chased a missing step in
a procedure that was never fully written down, and two of them were built on a
remark treated as a measurement.

### 2026-09-07 — RESOLVED: power off is one command, and only one

**Confirmed working: `power` (`0x07 00`), sent once, nothing after it.** The
projector shuts down and stays down.

Anything sent after the power key turns it back on. Operator's observation,
which settled it: *"it turns off, then right back on again."* The `OK` lands on
the next screen; a second power key is a second toggle.

**Operator's rule, now binding (see docs/12-power-logic.md):**

> Power on and power off send exactly ONE command each. If an action needs to do
> more, that belongs in the hub's automation or in a macro. Macros are the only
> thing that may send more than one command.

#### What actually broke it, in order

1. **2026-09-05, `0b1a4a0`** — removed the verify-then-retry from ACT_OFF. It
   was double-pressing power and occasionally turning the projector back on,
   which was real. But the retry had been masking that a single power key was
   sometimes enough and sometimes not, and its removal is when off became
   unreliable.
2. **Unconditional belief guard on off** — reads a belief that the power key
   itself mutates (`titanSendNamed` flips the assumed state on every send) and
   that returns stale from NVS after every reboot. It suppressed legitimate
   power-offs silently, before any frame was transmitted. The operator
   identified this as a race; it is worse than a race.
3. **Everything after that** — countdown-only, `OK` at 900 ms, `OK` at 2.5 s,
   `back` nudge, OSD prelude, ACK-confirmed retries, swapping `wake` for the
   power key — was built to explain failures caused by 1 and 2.

#### Confounded conclusions that were stated as findings

- **"`wake` poisons the projector."** The controlled test sent the power key
  *alone*; the hub also sends `InputHDMI1` 1.4 s later. Two variables changed
  and the wrong one was credited.
- **"The countdown self-completes into shutdown."** Taken from one unverified
  operator remark and used to justify two rewrites.
- **"`OK` is required."** Inferred from a capture in which the operator pressed
  OK manually. The confirm was never required; the *absence* of anything after
  the power key was what mattered.

#### The process failure

`OK` was removed once, correctly, in the same build that added the `back` nudge.
When that build failed, the nudge was blamed and `OK` was restored — the right
change was reverted because two things were changed at once. That single mistake
cost most of a day, and it is the reason "change one thing at a time" is now
written into docs/12-power-logic.md as a rule rather than advice.

### 2026-09-07 — VERIFIED FIX: power off sends the power key twice

```
[2956.376] TX 2A 2A 02 07 00 09              on, one frame
[3086.243] TX 2A 2A 02 07 00 09  key 1 of 2  off
[3088.246] TX 2A 2A 02 07 00 09  key 2 of 2  +2.003 s
```

Full cycle from the SofaBaton activity. Operator: **"IT WORKS!"**

**The first power key after a power-on is swallowed by the projector.** Proven
with two byte-identical acknowledged frames 91 s apart — the first ignored, the
second raising the countdown. The original firmware sent it twice by accident
(its `probeAnswered()` retry always fired), which is why off "worked perfectly"
before 2026-09-05 and why removing that retry broke it.

Also fixed in this build, and independently significant: **`<power-mode>` in the
Roku device-info was hardcoded to `DisplayOff`.** It read `titanPower()`, which
returns a value that never leaves `PWR_UNKNOWN` in this build. The bridge told
the hub the projector was off on every single poll, including while it was on.
The operator identified this ("this issue is 1000% on the titan-bridge side")
after being told, wrongly, that it was projector-side.

**0.8.2 and 0.8.3 are broken and should not be used.**

### 2026-09-08 — OIKWAN FTDI + MAX3232 binds; back-powering measured

**A second adapter class works.** OIKWAN USB↔RS232 + MAX3232 level shifter: the
projector binds it and answers normally (`linkalive=True`, temperature frames
returning). "Only FTDI binds" should now read: FT232RL and OIKWAN-FTDI both
bind; CP2102 and CH340 do not; **PL2303TA remains untested**.

**Back-powering, observed directly.** With the ESP32 unpowered and the FTDI
cable in the projector, a dim red LED lights on the ESP32 — the adapter's TXD
idling at 3.3 V, conducting through GPIO18's ESD clamp into the ESP32's rail.
The reverse case is the concerning one: ESP32 on external power, projector in
standby, GPIO17 idling into an unpowered adapter. Unproven as a wake cause, but
it is a real electrical fault and now designed out by the MAX3232 build.

**Wiring note:** TX/RX reversed on first assembly — frames out, `rx=0`. With a
MAX3232 there are two places to get it wrong and swapping both cancels out.

## 2026-09-10 — RESOLVED: the spontaneous power-on was an XGIMI setting

**Root cause: `Settings → General → Advanced Settings → Power On/Off Settings →
"Auto Power Off When Inactive"` (labelled "Turn off when not in use").**

Set to anything other than **Never**, it powers the projector **ON** that many
minutes after it has been switched **off**. It was set to 10 minutes. The
projector woke ~10 minutes after every shutdown.

This is an XGIMI firmware bug — the setting does the opposite of its label.
Workaround: set it to **Never**. Reported to XGIMI.

### Why this took three days

The setting was added **during troubleshooting**, as a stop-gap to stop the
projector running unattended while we worked. So the fault appeared at the same
time as our changes and correlated with every one of them. Theories built on
those coincidences, in order, all wrong:

| theory | what actually killed it |
|---|---|
| `wake` (0x09) poisons the projector | confounded — the test omitted the hub's `InputHDMI1` |
| the `OK` confirm wakes it | wakes happened with no `OK` |
| the no-signal HDMI screen blocks power | the OEM remote failed there too |
| `InputHDMI1` puts it in a bad state | wake happened without it |
| SSDP rediscovery → hub re-asserts PowerOn | real and fixed, but not this |
| the 10 s temperature poll | gated off; wake continued with `tx=0` |
| the hub's `Select` after PowerOff | wakes happened with no `Select` |
| a device on HDMI 2 | unplugged; wake continued |
| serial-off vs remote-off | the timer fired regardless of how it was turned off |

**The operator found it**, by reading the projector's own power menu.

### The lesson

**A mitigation added during an investigation becomes a variable in that
investigation.** The stop-gap was introduced to reduce harm and was never
entered on the list of things that had changed — so every subsequent
observation was measured against a baseline that had already moved.

Record what you change *while* debugging, not just what you were debugging.
And when an interval is strikingly precise and constant, look for a configured
timer with that exact value before theorising about mechanisms.

## 2026-09-11 — "serial stopped working after a period of time"

### What was measured

| | |
|---|---|
| UART1 internal loopback self-test | **PASS** — 6 bytes returned. The ESP32 drives the line; the frame parser works. |
| Frames transmitted | 2,834 over 7.8 h |
| Bytes received | **0** — `rxBytes` counts junk too, so not even line noise reached GPIO18 |
| Heap | flat at ~129 kB. Not a leak. |
| Projector | **powered** — pings on the LAN, port 53 open, MAC in ARP |
| Commands sent while the operator was using it | `InputHDMI2` → `LOST after 2 retries` |

Boot #39 ran for **3.25 hours** and then every command began failing and never
recovered until a reboot. That is the "works, then stops" signature.

### Fixes made

**UART recovery.** If the bridge has been transmitting and nothing at all has
come back for 90 s, UART1 is torn down and re-initialised (at most once a
minute). The suspected mechanism is the projector's USB rail dying mid-byte when
it powers off, which kills the adapter and leaves RX floating — a break or
framing error the ESP32 driver may not recover from on its own. Verified firing:
`UART1 reset — 9 frames sent, nothing received for 90 s`. It did **not** restore
communication here, so the wedged-UART theory is not the cause in this instance.

**`/api/selftest`** — loops UART1 back on itself and reports whether the board is
driving the line. This answers in one call the question that sent three separate
investigations into this firmware looking for a fault that was never in it.

### Two bugs introduced and fixed in the same session

- The self-test's looped-back frame **set `serialEverWorked` in NVS** — a false
  positive claiming the projector had answered when it was our own transmission.
  Now suppressed while the self-test runs.
- The actionable "sending but nothing comes back" message was gated on that same
  persisted flag, so the false positive hid it. It now keys on this boot's
  counters.

### Where it stands

The firmware is **proven innocent**: loopback passes, config unchanged
(GPIO17/18, 115200), transmission confirmed. The projector is powered. The fault
is in the physical path — adapter, cabling, or whether the projector is binding
the adapter at all. No firmware change can reach it.

### 2026-09-11 — resolved: physical re-plug restored it

Operator unplugged the adapter from the projector and plugged it back in.
Immediately healthy:

```
linkalive = True
tx / rx   = 2 / 96
lastrx    = 2A 2A 03 13 01 00 17    real temperature status
```

**Root cause: the projector's USB host had lost its binding to the adapter** and
only a physical re-attach makes it re-enumerate. Nothing in this firmware could
cause or fix it — the UART self-test passed throughout. See R-0005.

Rig at the time was the **MAX3232 + OIKWAN USB→RS232** build, which has no
back-powering path — the ESP32 drives only the MAX3232, powered from its own
rail, and the link to the adapter is RS232. An earlier note here blamed
back-powering; that was carried over from the direct-TTL wiring and is wrong for
this hardware.

The app now leads with that remedy when it detects the state (transmitting, zero
bytes back), instead of listing things to check.
