digunderground/titan-bridge/firmware/titan_bridge_p2/icon.h

/* icon.h — app icon, served at /icon.png so iOS can use it for
   "Add to Home Screen". A data: URI does not work there.
   Generated, not hand-written: 180x180, the size iOS wants at @3x. */
#pragma once
#include <Arduino.h>

static const uint8_t APP_ICON_PNG[] PROGMEM = {
  0x89,0x50,0x4E,0x47,0x0D,0x0A,0x1A,0x0A,0x00,0x00,0x00,0x0D,0x49,0x48,0x44,0x52,
  0x00,0x00,0x00,0xB4,0x00,0x00,0x00,0xB4,0x08,0x02,0x00,0x00,0x00,0xB2,0xAF,0x91,
  0x65,0x00,0x00,0x14,0x0F,0x49,0x44,0x41,0x54,0x78,0xDA,0xED,0x9D,0x5B,0x97,0x15,
  0xD5,0x15,0x85,0xEB,0x37,0x24,0x2A,0x5E,0x1A,0x14,0x44,0x32,0x86,0x31,0x78,0x89,
  0x01,0xF3,0x94,0x44,0x72,0x51,0xD0,0x28,0xDD,0x34,0x22,0x22,0x21,0x28,0x9A,0x9B,
  0x1A,0x8D,0x10,0x30,0x31,0x92,0x3F,0x96,0xE7,0xFC,0x9C,0x08,0x06,0x51,0x68,0x92,
  0x53,0xB5,0x6F,0xEB,0xBA,0xAB,0xCE,0xE1,0x54,0xD5,0xAE,0x62,0x8D,0x31,0x9F,0xBA,
  0xEB,0xB4,0xC8,0xFE,0x98,0x73,0xAE,0x55,0x7D,0xEA,0x54,0xDF,0xB9,0x7F,0xC3,0x64,
  0x12,0x55,0xD9,0x5F,0x81,0xC9,0xE0,0x30,0x19,0x1C,0x26,0x83,0xC3,0x64,0x70,0x98,
  0x0C,0x0E,0x93,0xC1,0x61,0x32,0x38,0x4C,0x06,0x87,0xC9,0xE0,0x30,0x19,0x1C,0x26,
  0x93,0xC1,0x61,0x32,0x38,0x4C,0x06,0x87,0xA9,0x5F,0x38,0x76,0x9B,0x4C,0xA2,0x0C,
  0x0E,0x93,0xC1,0x61,0x32,0x38,0x4C,0x06,0x87,0x69,0x18,0x38,0x1E,0xD8,0x6D,0x32,
  0x89,0x32,0x38,0x4C,0x06,0x87,0x69,0x05,0x38,0xBE,0xFB,0xC0,0x6E,0x93,0x49,0xD4,
  0x3D,0x0A,0xC7,0x3F,0x4F,0xDE,0x59,0x4A,0x06,0xC7,0x3D,0x83,0xC2,0xF6,0x9D,0xAB,
  0x49,0x3B,0x59,0xF9,0xCB,0x16,0x2F,0xB9,0x07,0x71,0xA9,0xE6,0x0F,0x04,0xE1,0xE0,
  0xC4,0xCE,0x17,0x2B,0x69,0xF1,0x42,0x48,0x0C,0xC4,0xC5,0xE0,0x98,0x18,0x13,0x32,
  0x0D,0x5B,0x0B,0xDD,0xFE,0x07,0xD4,0x66,0x56,0xE0,0xCA,0x2F,0x6A,0xC9,0xAC,0xCC,
  0x95,0x92,0x6A,0x56,0x4C,0x44,0x87,0x10,0x69,0x08,0x47,0xFE,0x79,0xAD,0x5B,0xB5,
  0x8E,0x77,0x90,0xBB,0x92,0x11,0x03,0x59,0x09,0xA0,0x24,0x3B,0x31,0x38,0x0A,0xC2,
  0x82,0x31,0x81,0x80,0x20,0x1C,0xFC,0x7D,0xA1,0xD7,0xA1,0xBE,0x55,0x04,0xAE,0x61,
  0xC4,0x50,0x50,0x08,0x25,0xB3,0x40,0x64,0x01,0xC7,0x9E,0x29,0x8A,0x58,0x05,0x62,
  0x22,0xDA,0x03,0xA5,0xA1,0x3E,0xF2,0xBF,0x2D,0xF4,0xDA,0x4A,0x82,0xD0,0x20,0x50,
  0x92,0xA3,0x24,0x4A,0xA8,0x91,0x4C,0xF2,0x2F,0xB9,0x9A,0x32,0x16,0xC1,0x2A,0xB6,
  0x76,0xA2,0x4F,0x44,0x93,0x88,0x40,0x10,0x1A,0x3E,0xFB,0xF5,0x37,0x2B,0x4B,0x62,
  0x05,0x80,0xE2,0xEC,0xC4,0x7B,0x49,0x32,0x92,0xE9,0x22,0x52,0x4D,0x8F,0x0C,0x84,
  0x45,0x64,0xE2,0x36,0x65,0x42,0xA4,0xE1,0xD5,0x6F,0xAE,0x78,0xDD,0x4C,0x7A,0x45,
  0x11,0xBC,0xA6,0x79,0xD5,0xE2,0xE5,0x22,0x2B,0x8C,0x12,0x64,0x24,0x10,0x11,0x83,
  0xA3,0x47,0xC3,0xA8,0x43,0x84,0x62,0xD1,0xC2,0x44,0xA2,0xA1,0x39,0xF2,0xCB,0x50,
  0xC7,0x9C,0xBE,0x56,0xD4,0x7C,0x17,0x5C,0x0F,0xA0,0x69,0x58,0xC9,0x53,0x12,0x8C,
  0x04,0x20,0x32,0x31,0x0B,0xA9,0xE6,0x81,0x45,0xCC,0x0E,0xCC,0x04,0xA6,0xA1,0xE1,
  0xE0,0xAF,0x51,0x47,0x91,0x2E,0x01,0x91,0x6F,0xC5,0x97,0x78,0x62,0x20,0x2B,0x0D,
  0x28,0x94,0x92,0xB9,0x20,0x52,0x95,0x4F,0x46,0xAA,0x9C,0xAE,0x5B,0x20,0x2C,0xBE,
  0x25,0x58,0x50,0x26,0x30,0x0A,0xCD,0xD9,0xDF,0xB8,0xF4,0x32,0xD5,0x45,0x26,0x7E,
  0x4D,0xFD,0x42,0x8C,0x4B,0xCD,0x8A,0x44,0x09,0x2A,0x25,0x14,0x11,0x50,0x57,0x8B,
  0xE7,0xA3,0x9A,0x8A,0x61,0xC0,0x6E,0xE1,0xB1,0x80,0x56,0xE1,0xB2,0x83,0x30,0xC1,
  0x80,0xF0,0x67,0xFF,0x92,0xD3,0x7F,0x9D,0x3E,0x55,0x74,0x31,0xA9,0xB9,0x1E,0x42,
  0x83,0x41,0xC1,0x94,0xA4,0x6A,0x92,0xB2,0x86,0x74,0x91,0x89,0x58,0x48,0x55,0x78,
  0xF1,0x44,0x86,0x81,0x43,0x44,0xB0,0x8A,0x63,0x37,0xA3,0x4F,0xD4,0x4C,0x44,0x20,
  0x02,0x0A,0xF5,0xA9,0xFF,0x8A,0xEA,0x2F,0xBF,0xFC,0x4A,0x14,0xBF,0xF2,0x53,0x88,
  0x4B,0x02,0x05,0x7A,0x89,0x62,0x24,0x20,0x68,0x88,0x85,0x94,0x5C,0x54,0xAB,0x72,
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
};
static const size_t APP_ICON_PNG_LEN = 5192;
