digunderground/titan-bridge/firmware/titan_bridge_p2/macros.h

/* ===========================================================================
   macros.h — the anchored-navigation macro engine (plan §6).

   A macro is a semicolon-separated script. It runs one step per pass of
   macrosLoop(), never blocking, so the web server and Roku emulation stay
   responsive while a 30-step menu walk is in progress.

   Tokens
     s:<name>     serial command from the XGIMI table, e.g.  s:hdmi1
     h:<name>     HID keyboard key, e.g.  h:menu     (no serial equivalent)
     r:<hex>      raw frame, e.g.  r:2A2A020101 04
     p:on p:off   power state machine, idempotent
     d<ms>        delay, e.g.  d750
     anchor       back;back;back;setting — forces a known menu root
     <tok>*<n>    repeat, e.g.  s:down*3

   Example
     anchor; d500; s:down*4; s:ok; d400; s:right; s:ok; s:back*3

   Every step is followed by MACRO_STEP_MS unless an explicit d<ms> says
   otherwise. Tune per macro; find the fastest reliable value rather than
   using one global number.

   User macros are stored in NVS and survive a reflash, so the menu mapping
   you do on Sunday is not lost the next time you rebuild the firmware.
   =========================================================================== */
#pragma once
#include <Arduino.h>

void   macrosBegin();
void   macrosLoop();

bool   macroRun(const char *name);        // false = no such macro
bool   macroRunScript(const char *script);
void   macroAbort();
bool   macroBusy();
const char *macroCurrent();

bool   macroDefine(const char *name, const char *script);  // persists
bool   macroDefineIn(const char *name, const char *group, const char *script);
bool   macroDelete(const char *name);
String macroListJson();
String macroScript(const char *name);     // "" if unknown
String macroGroup(const char *name);      // "" if ungrouped or unknown

// ------------------------------- recorder ----------------------------------
// Capture what was actually pressed, and the real gaps between presses, then
// save it as an ordinary macro. Nothing here is a separate execution path: a
// recorded macro is a normal script and stays editable as text.
void     recStart();
void     recStop();
void     recClear();
bool     recActive();
uint16_t recCount();
void     recCapture(const char *tok);     // called from the dispatch points
void     recSuppressNext();               // skip exactly one inner capture
void     recSuppressClear();
bool     recDeleteStep(uint16_t idx);
bool     recInsertStep(uint16_t idx, const char *tok, uint16_t gap);
String   recJson();
String   recScript();
bool     recSaveAs(const char *name, const char *group, uint16_t maxGap);
String   recScriptTimed(uint16_t maxGap);

// --------------------------- button assignments ----------------------------
// The virtual remote's buttons are data. Each id maps to a label and an action,
// where an action is any macro script fragment: "k:up", "m:movie night", "s:hdmi1".
bool   buttonSet(const char *id, const char *label, const char *action,
                 const char *icon, const char *style);
bool   buttonClear(const char *id);
String buttonsJson();
String buttonAction(const char *id);
bool   buttonMove(const char *id, bool up);

// ------------------------------ Roku apps ----------------------------------
String macroAppsXml();                    // user macros as <app> entries
bool   macroRunAppId(int id);             // launch by the id published above
String macroNameByIndex(int idx);
