digunderground/titan-bridge/(commit log)

2026-09-04 XGIMI TITAN Noir control bridge: firmware, runbook, tools
    Phase 1 diagnostic sketch and Phase 2 production bridge, both pure
    arduino-esp32 with no external libraries. Command frames verified
    byte-for-byte against XGIMI's published command-set image.
    Claude-Session: https://claude.ai/code/session_01FRBCD5W2KW9Qg617KfLn2U
    [menu-map.csv]
2026-09-04 chore: adopt primer harness
    Wire the primer harness into the existing XGIMI TITAN Noir bridge repo:
    CLAUDE.md/AGENTS.md Harness blocks, docs/{adr,research,atoms,deliverables},
    docs/RECALL.md, .claude hooks, .githooks, .env.example, graph.
2026-09-04 feat(firmware): board profiles + UART0 onboard-bridge channel
    Any dev board with an onboard CP2102/CH340 already is a USB-serial dongle:
    plug its own USB port into the projector and the daemon binds it as
    /dev/ttyUSB0. Adds CH_UART0 so the bridge can drive the projector through
    its own bridge chip, which makes the Phase 2 dongle path reachable with a
    USB cable and no external module.
    - config.h: BOARD profiles for S3-DevKitC, Heltec LoRa V3/V4 and classic
    ESP32, each with its own pins and default channel set. Heltec remaps
    UART1 off GPIO17/18, which its OLED owns.
    - Boards without native USB mask CH_NATIVE_CDC out rather than failing to
    build; asking for only that channel there is a c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
    [config.h, titan.cpp, titan_bridge_p2.ino]
2026-09-04 docs: keyboard probe sheet, pre-Day-1 findings, verified builds
    Test 1 is answered ahead of the hardware: a plain USB keyboard drives the
    projector's OSD, so the USB host enumerates, the HID driver loads and key
    events reach the menu. The remaining HID risk is only whether the S3's
    TinyUSB stack is accepted on the same terms.
    - logs/TEST-LOG.md: pre-Day-1 findings — Serial Port Control confirmed
    present and on; keyboard drives the OSD.
    - docs/10-hid-key-probe.md: sheet for verifying HIDKEYS[] (twelve usage
    codes that are currently untested assumptions — volup/voldn/focus+/focus-
    especially) and for counting the five menu paths serial cannot reach,
    by hand, with a keyboard.
    - doc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
2026-09-04 feat(tools): fake_projector.py — desk-test the bridge with no projector
    titan_serial.py drives a real projector from the laptop; this is the inverse.
    It sits on the far end of the bridge's serial link, decodes what the firmware
    emits, and answers the temperature probe so the power state machine has
    something to believe.
    Verified against a HiLetgo ESP-WROOM-32 flashed with BOARD=3 (CH_UART0), the
    board talking through its own onboard USB-serial chip:
    [ 2.9s] RX 2A 2A 02 13 00 15 instruction 0x13
    TX 2A 2A 03 13 01 00 17
    [ 12.8s] RX 2A 2A 02 13 00 15 (+10.0s)
    [ 22.8s] RX 2A 2A 02 13 00 15 (+10.0s)
    3 frame(s) decoded, 161 byte(s) discarded as non-frame
    That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
2026-09-04 test: bridge bring-up verified end-to-end without a projector
    HiLetgo ESP-WROOM-32 running p2 with BOARD=3 (CH_UART0), talking through its
    own onboard USB-serial chip, with tools/fake_projector.py standing in for the
    projector on the far end of that link.
    [5.325] TX 2A 2A 02 13 00 15
    [5.403] RX 2A 2A 03 13 01 00 17 temp=normal
    [6.830] power state -> awake
    /api/status: power=awake temp=normal rx=14 lastrx="2A 2A 03 13 01 00 17"
    Proven: frame builder and checksum, TX and RX through the onboard bridge,
    frame decode, both directions of the power state machine (awake on reply;
    asleep at 29.0s after 3 unanswered probes), Wi-Fi, mDNS, REST API and Roku
    ECP. Boot chatter resynced away harm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
2026-09-05 test: Test 2 FAILED — projector does not bind a CP2102; set USB_DEAD_IN_STANDBY
    The TITAN Noir Max never opens a serial port for a CP2102. Ruled out in turn:
    bridge firmware (fake_projector round-trips the same build), the cable (it
    enumerated on the laptop through the projector's own cable), chip class (it is
    already cp210x, one of the three drivers the plan expects), Serial Port Control
    being off, the daemon not starting at boot (full mains cycle), the USB port
    (a keyboard drives the OSD through it), and ID addressing (7 header variants
    including A0, *0, A*, and address before/after the header).
    The decisive observation: uptime climbs monotonically the whole time the board
    is attached.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
    [config.h]
2026-09-05 test: Test 5 corrected — USB ports STAY powered in standby
    Measured, not inferred: the bridge was on a projector USB port with no other
    power source, the projector was switched off, and it stayed up — Wi-Fi held and
    uptime climbed straight through (355s, 361s, 367s, no reboot).
    An earlier impression that the ports died in standby was wrong; that was
    mains-off, not standby. Reverts USB_DEAD_IN_STANDBY to 0.
    This reopens discrete power-on. The bridge survives standby, so it is still
    there to wake the projector — the premise plan §5 is built on. Serial cannot
    carry the wake (Test 2 failed on this model), which leaves one candidate:
    an HID keypress on the native USB port. A keyboard alr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
    [config.h]
2026-09-05 docs: record why rx=0 rules out an addressed-reply we failed to parse
    rxBytes++ is the first statement in rxByte(), before the 2A 2A header check,
    so rx counts every byte off the wire regardless of header, framing or
    validity. rx=0 across ~50 transmitted frames therefore means the receive line
    was electrically silent — not that the projector answered with an A0-style
    addressed header the decoder discarded, which is the obvious worry once the
    projector turns out to expose ID addressing.
    Also notes the signature to watch for on the CH340/PL2303 attempts: rx climbing
    while the log shows no RX lines would mean bytes arriving that never frame up,
    which would put addressing back on the table.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
2026-09-05 docs: retract "vestigial UI" theory — likely a missing cp210x kernel driver
    Checked against XGIMI's own help-centre article (53406154382361) and the
    TITAN Noir port list. The article is titled "How to use the RS232 on the
    TITAN?" and the projector has no DB9 — 2xHDMI, 2xUSB, RJ45, 3.5mm — with
    RS232 control explicitly delivered through an RS232/USB adapter in a USB
    port. The USB-adapter premise this project rests on is therefore correct,
    and Serial Port Control is a real implemented feature, not inherited UI.
    The likelier explanation for total silence is that the projector's kernel
    does not carry cp210x. Embedded builds ship a subset of the usb-serial
    drivers; with cp210x absent a CP2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
2026-09-05 feat: runtime key channel, honest link state, adapter test procedure
    Prepares the code for tomorrow's adapters and for the possibility that the
    serial channel never works on this model.
    Two bugs found while wiring this up:
    - statusJson's "link" field never learned about CH_UART0, so it rendered as
    an empty string on exactly the build we have been running all evening.
    - The power state machine declared PWR_ASLEEP after POLL_MISSES_TO_SLEEP
    unanswered probes even when it had never received a single byte in its
    life. On a projector that never binds the adapter, that reports "asleep"
    for a projector that is wide awake — and Home Assistant and the Roku
    emulation would both have beli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
    [config.h, ecp.cpp, macros.cpp, titan.cpp, titan.h, titan_bridge_p2.ino]
2026-09-05 docs: bring README in line with what the hardware actually said
    The entry point claimed RS232-over-USB as settled fact and listed as "known
    unknowns" two questions that now have answers. Adds a status note up front,
    marks Q1 (CDC/serial binding — no, and neither does CP2102) and Q2 (ports stay
    powered in standby — yes) as answered with their evidence, and adds the
    question those answers create: does an HID keypress wake it from standby.
2026-09-05 fix: liveness needs a valid frame, not a byte; bias floating UART1 RX
    Caught on the S3's first boot. With nothing attached to UART1, the bridge
    reported rx=1, linkalive=true and then "power state -> asleep" — for a
    projector that was not even connected. One noise byte on a floating GPIO18
    was enough to defeat last night's "has the link ever spoken" guard.
    Two fixes:
    - frameComplete() now verifies the checksum and only a passing frame sets
    the liveness flag. rxBytes still counts every byte for diagnostics, so
    "bytes arriving that never frame up" remains visible — that signature is
    how docs/11 says to spot an unexpected header.
    - pinMode(P2_RX_PIN, INPUT_PULLUP) before Serial1.begi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
    [titan.cpp, titan.h]
2026-09-05 feat(tools): provision_wifi.sh — credentials from .env, never through an agent
    The bridge's Wi-Fi is set over the UART console, which means the password has
    to reach it somehow. This reads it from .env so it never appears on a command
    line, in shell history, or in an agent transcript — and so the project's own
    .env deny rule (.claude/settings.json, installed at adoption) stays intact
    rather than being worked around.
    Accepts WIFI_SSID with WIFI_PASSWORD/WIFI_PASS, or the TITAN_ prefixed forms,
    and lists the keys it did find if none match. Echoes the join progress but
    filters any line containing the password. Reports the 20-second join timeout
    explicitly, noting the bridge falls back to i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
2026-09-05 fix(tools): parse .env instead of sourcing it
    The shell version died on a real .env: "line 29: syntax error near unexpected
    token `('". A .env is not a shell script — values legitimately contain
    parentheses, spaces, $, quotes and #, all of which break `source` and some of
    which would execute. Replaces provision_wifi.sh with provision_wifi.py, which
    reads KEY=VALUE literally, strips one layer of matching quotes, and performs
    no expansion and no execution.
    Also stops guessing the port: on this S3 DevKitC-1 both the CH343 console and
    the S3's own native USB enumerate as /dev/cu.usbmodem*, so an automatic pick
    is as likely to grab the projector-facing port as the console. It now lists
    the can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
    [provision_wifi.py]
2026-09-05 test: Test 1 PASSED — the bridge controls the projector over USB HID
    ESP32-S3-DevKitC-1 running p2 with BOARD=1, native USB port into a projector
    USB port, powered from that same port, commanded over Wi-Fi from another room:
    [69.634] key channel -> hid
    [71.703] HID home (0x4A) -> OSD opened
    [74.779] HID down (0x51) -> selection moved
    [81.116] HID up (0x52)
    The plan had serial primary and HID as a gap-filler for Menu and manual focus.
    That is now inverted: serial does not exist on this projector, HID does, and it
    carries the navigation the macro engine needs. keychan hid makes that the
    routing for anchor and every k: step, so the counted paths in docs/05 and
    docs/10 work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
2026-09-05 fix: route the UI, ECP and built-in macros through the key channel
    The bridge could drive the projector but the web UI could not, because the
    UI's D-pad called /api/cmd — serial instruction 0x07 — which is dead on this
    projector. Only the one "Menu (HID)" button worked. The same was true of the
    SofaBaton path: every navigation entry in ECPMAP was s:, so the hub's arrow
    keys would have been silently inert too.
    - ecp.cpp: ECPMAP navigation (Up/Down/Left/Right/Select/Back/Home/Options and
    the volume pair) now uses k:, so it follows the active channel. Input and
    picture entries stay on s: — they have no HID equivalent and need menu
    macros instead.
    - New /api/nav?name= dispatches a k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
    [ecp.cpp, macros.cpp, webui.h]
2026-09-05 feat: discrete power over HID; HIDKEYS rewritten from measurement
    The HID key probe found the thing the project was built to obtain.
    0x66 (Keyboard Power) is a discrete power toggle that works in BOTH
    directions on a TITAN Noir Max: it switches the projector off, and it wakes
    it from standby. No serial channel, no smart plug, no HDMI-CEC.
    Also found: 0x65 — the previous "menu" binding — does nothing. The macro
    anchor routed k:setting to it, so every anchored macro would have failed
    silently on the HID channel. 0x4A (Home) is the real menu key. Caught before
    any macro was written against it, which is what the worksheet was for.
    - HIDKEYS rewritten from measurement rather than assumptio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
    [ecp.cpp, titan.cpp, titan.h, webui.h]
2026-09-05 docs: drop stale pre-results prose from the HID probe sheet
    Section 1 still described the table as untested guesswork and speculated about
    what might happen, immediately above the measured results. It is a record now,
    not a worksheet; section 2 (counting menu paths) is the part still to fill in.
2026-09-05 fix: stop inferring power from a USB event that proves nothing
    The round-trip test caught a bug worse than the problem it was meant to solve.
    usbStateKnown was being set by ARDUINO_USB_STARTED_EVENT, which fires when our
    own device stack initialises and says nothing about the host. The bridge
    therefore believed the projector was awake, and:
    [230.146] power off: HID power key -> projector off
    [244.254] power off: HID power key -> toggled it back ON
    [252.343] power on: already awake -> sent nothing
    A second "off" turned it on, then "on" did nothing. A blind toggle would have
    behaved better than a confident wrong answer.
    Measured: this projector does NOT suspend its USB bus in s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
    [ecp.cpp, titan.cpp, titan.h]
2026-09-05 feat: macro recorder, groups, button assignments, macros as Roku apps
    Firmware foundation for the tabbed UI. Verified on hardware: recording three
    navigation presses captured exactly three steps with measured gaps of 1090 ms
    and 1070 ms against 1 s sleeps, and saved into a named group.
    - Recorder: captures each dispatched key with the real elapsed gap, then
    compiles to an ordinary macro script. That also settles MACRO_STEP_MS
    empirically — the recorded gaps are the ones the OSD actually kept up with,
    rather than a guessed constant. Steps can be deleted and inserted before
    saving. /api/rec, /api/recstep.
    - titanKey() records the channel-neutral k: form and suppresses the inner
    h: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
2026-09-05 feat(ui): tabbed console — remote, macro recorder/editor, settings
    Replaces the single scrolling page with three tabs.
    Remote (the landing tab, because it is what you want when something is wrong):
    power, a D-pad and the navigation keys — all through /api/nav so they follow
    the active key channel — plus a grid of buttons you assign yourself. An Edit
    mode turns each button into a label and an action, where an action is any
    script fragment: k:up, m:movie night, s:hdmi1.
    Macros: grouped list, the recorder, and a step editor that renders a script as
    chips rather than a line of text, so insert/delete/replace are single clicks
    and there is an explicit + between every pair of steps. Chips a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
    [ecp.cpp, webui.h]
2026-09-05 feat(ui): remote tab styled as a physical remote
    Reworks the landing tab to read like the handset it replaces rather than a
    web form: a rounded dark body, circular power and mute keys, pill-shaped
    Menu/Back, vertical rockers for volume and focus, and a purple ring D-pad with
    an OK hub.
    The D-pad is four clip-path wedges around a centre circle, with the two
    diagonals drawn in the body colour as seams — the wedges meet on the diagonals,
    so the seams are diagonals too, and a seam line has to be ~1.5x the box to
    reach corner to corner once rotated.
    Behaviour is unchanged: every key still goes through /api/nav, so it follows
    the active key channel.
    [webui.h]
2026-09-05 feat(ui): button assignment is a form, not a chain of prompts
    Adding a button was three prompt() dialogs that required typing an action
    string correctly. The actions that exist are known, so they should be picked.
    - Action is a <select> with the existing macros first (binding one is the
    common case), then grouped built-ins: power, navigation, sound and lens, and
    the serial commands — with "Custom script…" revealing a text field for
    anything the list cannot express.
    - Icon is picked from a palette, with ∅ for none.
    - Look is a shape (pill or circle) and a colour, with a live preview that
    updates as the label is typed.
    - Editing an existing button loads its current values, and D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
    [ecp.cpp, macros.cpp, macros.h, webui.h]
2026-09-05 feat(ui): full-bleed remote on mobile, buttons on the remote body, reordering
    Three fixes from using it.
    - On a phone the remote is now the screen rather than a card floating in one:
    full-bleed under 560px, no side borders, and the D-pad scales with the
    viewport (min(76vw,300px)) instead of staying a fixed 212px.
    - Assigned buttons moved onto the remote body, below the volume and focus
    rockers, in a grid — two wide on desktop, four wide on a phone — instead of
    sitting in a separate card underneath.
    - Edit mode now shows explicit controls under each button rather than quietly
    changing what a press means: pencil to edit, arrows to reorder, with the end
    buttons disabled at the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
    [ecp.cpp, macros.cpp, macros.h, webui.h]
2026-09-05 docs: dual-path wiring — HID on one projector port, serial on the other
    Now that HID works and serial does not, the plan's target architecture is the
    right next experiment rather than a later phase: native USB carries HID on one
    projector port while a CH340 carries serial on the other. The channels are
    independent, so the working one keeps working while the other is tested.
    Adds hardware/wiring-dualpath.svg and a docs/03 section. No firmware change is
    needed — BOARD=1 already enables CH_NATIVE_CDC | CH_UART1, so the bridge has
    been transmitting frames out GPIO17 the whole time with nothing attached.
    Records what success looks like (rx climbs, RX lines appear, and the UI's
    serial button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
2026-09-05 fix: the temperature probe outranks USB bus state as a liveness signal
    Caught the moment a second liveness source existed. Bench-testing the CH340 on
    UART1 with the native USB port in a laptop hub, the power state oscillated
    twice a second:
    [1534.042] power state -> awake
    [1534.044] power state -> asleep
    The temperature probe said awake; the USB bus said asleep — because the native
    port was plugged into the laptop, and the laptop had suspended it. USB bus
    state is only evidence about whichever host that port is attached to, which on
    the bench is not the projector.
    A reply to the temperature probe is an answer from the projector itself, so it
    now wins whenever it is available; USB bu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
    [ecp.cpp, titan.cpp]
2026-09-05 fix: "awake" needs a valid frame too; CH340 does not bind either
    Same bug as last night, surviving in the other direction. probeAnswered()
    still tested everRx — any byte — so a single byte of line noise when the CH340
    was first connected was enough to report the projector awake:
    rx=1 lastrx=[-] linkalive=false powerobserved=false power=awake
    No frame had ever been decoded. "Asleep" already required a checksum-valid
    frame; "awake" now does too, tracked by lastFrameAt rather than lastRxAt.
    After the fix the same hardware honestly reports rx=0 and an assumed state.
    Test result: the CH340 does not bind. The wiring was proven first with the
    laptop standing in for the projector — fr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
    [titan.cpp]
2026-09-05 fix: SSDP stopped receiving seconds after boot; /query/apps was empty
    The hub could never have found the bridge, for two independent reasons.
    1. Multicast reception died within seconds of every subscribe. Instrumenting
    every inbound M-SEARCH — not just matching ones — showed inbound SSDP only
    ever arriving in a short window after beginMulticast():
    t=2.5-7.2s initial subscribe
    t=67s after a re-arm at ~63s
    t=127s after a re-arm at ~123s
    Cause: announcements were sent with beginPacket()/endPacket() on the same
    WiFiUDP object that was joined to the group. On this stack that
    reconfigures the socket and drops its membership. Split into ssdpRx (jo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
    [ecp.cpp, macros.cpp, net.cpp]
2026-09-05 feat: lean on outbound SSDP, which is the direction that actually works
    Measured asymmetry on this network: the bridge's NOTIFY announcements are
    heard fine (a laptop joined to the group received them), while inbound
    M-SEARCH from the SofaBaton hub and from that same laptop never arrives —
    though searches from two other LAN devices do. Discovery therefore cannot
    depend on hearing the search.
    - Announce every 10 s instead of every 60 s. A client that listens for
    ssdp:alive finds the bridge without its own search ever reaching us, and a
    ~200 byte datagram at that rate costs nothing.
    - Accept unicast M-SEARCH aimed straight at our IP on port 1900.
    beginMulticast() alone does not delive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
2026-09-05 docs: record how SofaBaton discovery actually succeeds
    The documented model — app multicasts M-SEARCH, bridge answers — is not how it
    worked here, and assuming it did cost an afternoon of debugging inbound
    multicast that was never on the critical path.
    Measured: the bridge's inbound multicast was unreliable (searches from two LAN
    devices arrived, the hub's and a laptop's never did) while its outbound
    announcements were heard reliably. Discovery succeeded the moment the announce
    interval dropped from 60s to 10s, and the app came straight to :8060 without
    ever sending us a search:
    [18.681] ECP root <- 10.0.0.124 <- the phone, unprompted
    So the app listens for ssdp:alive. Docume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
2026-09-05 fix: power buttons appeared reversed — a blind toggle behind discrete labels
    Tracing a SofaBaton session showed the ECP mapping was correct all along:
    [211.375] ECP /keypress/PowerOn <- 10.0.0.118
    [211.378] power on: already on (assumed) <- suppressed
    [213.334] ECP /keypress/PowerOff <- 10.0.0.118
    [213.369] HID power (0x66) <- acted
    The hub sends the right keys. The problem was what the bridge did with them.
    I briefly defaulted to "obey" — always send the power key — reasoning that a
    hub which tracks its own state should not be second-guessed. That was wrong,
    and made it worse: 0x66 is a *toggle*, so obeying blindly means PowerOn on an
    already-on proj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
    [config.h, ecp.cpp, titan.cpp, titan.h, webui.h]
2026-09-05 docs: record the SofaBaton integration working end to end
    The hub drives the projector: power, navigation and macros arrive over Roku ECP
    and go out over USB HID.
    Records the two blockers that made discovery impossible (SSDP reception dying
    after every self-announcement; an empty /query/apps), the mechanism that
    actually worked (the app listens for ssdp:alive rather than needing its search
    to reach us), and the "reversed power buttons" diagnosis — a toggle behind
    discrete labels with a belief one state out, self-perpetuating because each
    press flipped both the belief and the projector.
2026-09-05 chore: scrub the Wi-Fi SSID from docs
    RFC1918 addresses stay — they are meaningless outside the LAN and make the log
    excerpts concrete. A network name is the one string that identifies a location.
2026-09-05 feat: serial works — FTDI binds; decode the undocumented ACK protocol
    ftdi_sio is in the projector's kernel. Third driver class tried and the one
    that binds: CP2102 no, CH340 no, FT232RL yes. Wiring was proven on the bench
    before each attempt with the laptop standing in for the projector, so every
    earlier failure was unambiguously driver support rather than the rig.
    Two things XGIMI does not document, both measured:
    - Every accepted command is acknowledged as
    2A 2A 02 <instruction | 0x80> <parameter echoed> <checksum>.
    That is more useful than the temperature probe, because an unsupported
    command is detectable by the ABSENCE of an ACK — which makes the
    undocumented parameter sp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
    [titan.cpp, titan.h]
2026-09-05 fix(docs): retract the claim that a missing ACK means unsupported
    Published a few commits ago and wrong. The reading was appealing — an
    unsupported command going unacknowledged would have made the undocumented
    parameter space testable without watching the screen — so it went into
    docs/06 and TEST-LOG before the control was run.
    Sweeping instruction 0x01 ACKs EVERY parameter tried, including 0x7F, 0x80,
    0xC0 and 0xFE, none of which can be real inputs. The ACK confirms a frame was
    received and parsed, and nothing more.
    Consequently hdmi3 is back to unproven: it ACKs, but so does 0xFE. Only the
    screen can answer it.
2026-09-05 feat: control channel is a saved setting, gated on a live serial link
    Adds an explicit Settings choice between ESP32 (USB HID) and Serial adapter,
    persisted across reboots.
    Serial is only selectable once a valid frame has actually arrived. Without the
    gate, choosing it with no adapter attached leaves every navigation key silently
    doing nothing — the exact failure that took an evening to diagnose the first
    time. The UI disables the option and says why; the firmware refuses it too,
    since /api/keychan is reachable from Home Assistant and the hub.
    A saved preference for serial is honoured but not trusted blindly: titanKey()
    falls back to HID until the link has spoken, so a reboot with the ad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
    [ecp.cpp, titan.cpp, titan.h, webui.h]
2026-09-05 test: serial confirmed on screen — wake, navigation, and HDMI3 is real
    All three watched on the projector rather than inferred from an ACK, which
    acknowledges receipt only and acknowledged every parameter tried including 0xFE.
    - Serial wake (2A2A 07 09 wakeup 9D) turns the projector on from standby. A
    real discrete power-on, unlike the HID power key which is a toggle — no
    assumed state, nothing to drift.
    - Serial navigation (instruction 0x07) drives the OSD: menu opened, cursor
    moved three times, exited clean. So macros can run on serial and stop
    depending on the ESP32's native USB port.
    - hdmi3 is REAL. XGIMI's table lists HDMI1, HDMI2 and USB only, on a
    three-HDMI projector;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
2026-09-05 fix: the temperature probe answers in standby — it is not a power indicator
    Measured with the projector switched off: replies kept arriving at exactly the
    same rate, reporting normal.
    t=10s power=awake temp=normal rx=2483
    t=80s power=awake temp=normal rx=2819 <- 48 bytes/10s, unchanged
    The plan's liveness model — a reply means awake, silence means asleep — is
    false on this projector. Its serial daemon runs in standby, so a reply proves
    the link works and nothing more.
    This retracts the verified-power-state claim made when serial first bound,
    which was published. powerobserved is now true only for a genuine USB bus
    transition, which this projector does not produce eithe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
    [config.h, ecp.cpp, titan.cpp]
2026-09-05 test: commands are honoured in standby — input can be pre-selected
    Left on HDMI3, switched off. With it off, hdmi1 was sent and ACKed, then wake.
    It powered on displaying HDMI1.
    So the serial daemon does not merely answer queries in standby, it acts on
    commands. A macro can wake the projector straight onto the right input rather
    than waking it and then walking a menu — "s:hdmi1; d200; s:wake" instead of a
    wake, a settle delay and a navigation sequence.
2026-09-05 fix(homeassistant): the power switch would have read permanently off
    The package was written when the plan assumed the temperature probe reported
    power. It matched sensor.titan_power_state against "awake", which the bridge no
    longer emits — the string is now "on (assumed)" / "off (assumed)" because this
    projector answers the temperature probe identically in standby. The switch
    would have shown OFF forever while the projector was on.
    Matches both forms now, so it keeps working if a unit is ever found that does
    report state.
    Also corrects a comment claiming the switch "cannot get out of step with
    reality for longer than one poll". It can, indefinitely: nothing reports power,
    so someone usi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
2026-09-05 fix: Menu was dead on the serial channel — translation only went one way
    The remote's Menu button sends /api/nav?name=menu. On serial that reached
    titanSendNamed("menu"), and the serial table has no "menu" — it has "setting"
    (0x07 0x0F). The key silently did nothing.
    The translation existed, but only in the HID direction (setting -> menu). It
    now goes both ways, so a key written against either vocabulary works on either
    channel.
    Also makes the failure legible. "unknown key" sent me looking at the key when
    the key was fine and the channel simply had no equivalent; the log now names
    the channel that refused it.
    Verified on hardware, both directions:
    serial menu -> TX 2A 2A 02 07 0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
    [titan.cpp]
2026-09-06 fix: keep the assumed power state honest whichever door a command came through
    Two paths changed the projector without the power state machine noticing:
    - /api/cmd?name=wake reaches titanSendNamed() directly, so the projector woke
    while the bridge went on believing it was off. That is why a parameter sweep
    was started against a projector the bridge reported as off.
    - /api/hidraw firing usage 0x66 does the same for the HID power toggle, and is
    how the assumed state drifted far enough yesterday to make the SofaBaton's
    power buttons appear reversed.
    Both now update the assumption at the point the command actually goes out,
    rather than only in titanPowerOn/Off/Toggle. Same class of bug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
    [titan.cpp]
2026-09-06 docs: instruction 0x07 sweep — 0x06 opens a calibration screen
    Swept 0x01-0x07 one code at a time with visual confirmation. XGIMI documents
    0x08-0x15; the range below was unexplored.
    0x06 opens a black-and-white calibration / test pattern — a service screen with
    no button on the remote and no mention in the published table. Exits with back.
    The other six acknowledge and do nothing.
    The remote's four shortcut keys are not in this range and may not be exposed
    over serial at all; assignable buttons backed by recorded macros reach the same
    outcome without undocumented codes.
    Stopped rather than sweeping 0x16+: the codes are sparse and another service
    screen is a likelier find than another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
2026-09-06 fix: power off turned the projector back on; rebuild the UI as an iOS app
    Two things.
    POWER OFF WAS UNDOING ITSELF. Switching the control channel to serial routed
    power through the ACT_OFF state machine, whose final step reads:
    if (!probeAnswered()) { /* success */ }
    else if (actTries < 2) { "still awake, retrying"; actStep = 0; }
    probeAnswered() is always true on this projector — it answers the temperature
    probe in standby — so a successful power-off looked like "still awake", the
    sequence pressed power a second time, and the projector came straight back on.
    The verification meant to make power reliable was what broke it.
    Both power actions now skip verify-and-retry when TEM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
    [ecp.cpp, icon.h, titan.cpp, webui.h]
2026-09-06 ui: keep the project's name on the landing tab, rockers flank the D-pad
    "Remote" was a tab label standing where the app's name belongs; the landing
    screen now reads Titan Bridge, with the other tabs keeping their section names.
    Volume and Focus were stacked in one column beside the D-pad, which is not how
    either a handset or a thumb works. One rocker each side now, with the D-pad
    sized to min(46vw,204px) so all three fit across a phone without crowding.
2026-09-06 docs: rewrite the README as the project's front door; release alpha 0.8
    The README had accreted three contradictory status blocks, one of which still
    claimed serial does not work on this projector — which was true for two days
    and has not been since.
    Rewritten around what someone arriving cold actually needs:
    - What works, and the one real limitation (nothing reports power state, so
    on/off track an assumption).
    - Known-good hardware, linked: the ESP32-S3-DevKitC-1 for its two USB ports,
    and the DSD TECH SH-U09G because FTDI is the only adapter class this
    projector binds. CP2102 and CH340 are called out as never working, with the
    note that the wiring was proven on a bench first in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
2026-09-06 fix: the log flushed itself every 2.5 minutes, hiding the evidence
    This invalidated several conclusions, mine included. The 10 s liveness poll
    emitted four lines per cycle — TX, the repeat-collapse notice, the ACK and the
    status — which is 24 lines a minute into a 60-line ring. Anything older than
    about two and a half minutes was gone, so "nothing arrived from the hub" and
    "the evidence scrolled away" looked identical, and I read it as the former more
    than once while diagnosing a SofaBaton problem.
    - Ring is 160 lines.
    - The poll is silent by default: no TX, no ACK, no unchanged status. A
    temperature that actually changes still logs, as one line. LOG_POLL_TRAFFIC
    restores the old be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
    [config.h, ecp.cpp, titan.cpp]
2026-09-06 feat: hub buttons are remappable from the app
    The compiled ECPMAP was a decision baked into firmware. A hub button that does
    the wrong thing — or a macro you would rather have on it — should be fixable
    from the app.
    - Overrides stored in NVS as "key\taction" lines, shadowing the table. Clearing
    one restores its default; Reset all clears the lot.
    - Settings lists every ECP key, what it runs, and whether it is overridden.
    Tapping a row offers saved macros, grouped built-in actions, or a raw script.
    - /api/ecpmap, /api/ecpset, /api/ecpreset.
    This also gives a way around the bridge's own logic when that is the problem.
    p:off consults an assumed power state that cannot be verified on th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
    [config.h, ecp.cpp, webui.h]
2026-09-06 fix: stop second-guessing power — the guard broke it more than it saved it
    The assumed-state guard exists because power-off is not idempotent: the power
    key on an already-off projector turns it on. That risk is real but rare. The
    guard's failure mode turned out to be constant — the belief cannot be verified
    on this projector and drifts whenever anything changes the projector without
    going through titanPowerOn/Off: a raw macro step, a remapped hub button, my own
    test commands, or the physical remote. A drifted guard makes the button
    silently do nothing, and the only fix is a manual resync in Settings.
    Silent failure needing manual repair is worse than a rare double-toggle,
    particularly w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
    [titan.cpp, webui.h]
2026-09-06 feat: per-macro Fast switch, and a timing cap when saving a recording
    A recorded macro played back the pauses the operator took while thinking,
    because the recorder measures real gaps — which is the honest thing to store,
    but a poor default to execute.
    Two controls, at different points:
    - Saving a recording offers a cap: fast (300ms), normal (600ms), relaxed (1s),
    or exactly as recorded. Gaps are clamped into RECORD_MIN_GAP_MS..cap.
    - Each saved macro has a Fast switch. "fast" is a marker token, not a step, so
    toggling it is a text edit on the script and the recorded timing survives for
    when it matters. At run time it drops every wait.
    The split matters: a macro that only fires di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
2026-09-06 feat: the app tells you whether the unit is running the latest release
    There was no way to know. Updating meant a laptop and espota.py, and nothing
    indicated a newer version existed.
    Settings now shows the installed version against the latest GitHub release,
    with a link and the exact OTA command when they differ.
    The check runs in the browser, not on the bridge. GitHub sends permissive CORS
    headers, so the phone asks directly — which keeps TLS, certificate handling and
    an outbound internet path off the device. A projector bridge that cannot reach
    the internet is a property worth keeping, not a gap to close.
    FW_VERSION was stale — it still read "titan-bridge-p2 1.0.0" while the repo wa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
2026-09-06 0.8.1-alpha: picture-mode findings, ACK-collapse fix, doc corrections
    Measured what instruction 0x03 actually does. Five of the seven documented
    picture modes ACK cleanly and change nothing; only Performance (0x05) and
    Filmmaker (0x1B) take effect, and neither appears in the projector's own
    on-screen mode list. All 25 undocumented parameters in the range do nothing.
    There is no serial parameter for Standard.
    Two corrections to claims this repo previously made:
    - An ACK proves receipt, not support and not effect. "No ACK means
    unsupported" was already retracted when a sweep ACKed 0xFE; a documented
    mode that ACKs and does nothing kills the converse too.
    - The command reference still sai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
    [config.h, titan.cpp]
2026-09-06 power: stop "off" turning the projector on, and stop racing the shutdown dialog
    The hub's Power off and Turn off buttons switched the projector ON when it was
    already off. Both send the same ECP key (/keypress/PowerOff) — there is no
    distinction between the two labels, which had been an open question since
    2026-09-05.
    Three faults, which had to be fixed together.
    1. Off is a toggle and was unguarded. titanPowerOff() skipped its believed-state
    check whenever powerObey was set, which is the mode in use, so an off sent to
    an off projector fired the power key and turned it on. The guard is now
    unconditional for off while on stays unguarded. The asymmetry is deliberate:
    wake is id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
    [config.h, ecp.cpp, titan.cpp, titan.h]
2026-09-08 0.8.2-alpha: the SofaBaton was turning the projector on
    Root cause of the "projector turns itself on" reports, finally captured:
    [18.279] ECP /keypress/PowerOn <- 10.0.0.118
    [18.290] TX 2A 2A 07 09 77 61 6B 65 75 70 9D
    Sixteen seconds after the bridge joined Wi-Fi, with nobody touching anything.
    The bridge announces ssdp:alive on boot, the hub sees its "Roku" reappear and
    re-asserts the power state it believes the device should be in. That explains
    every part of the pattern that never fit: why it followed use and shutdown (the
    hub's activity still believed the device was on), why the method of turning off
    was irrelevant (the hub only reacts to the bridge reappearing), and why the logs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
2026-09-08 0.8.3-alpha: power off is one command, and only one
    Confirmed working: power (0x07 00), sent once, with nothing after it. The
    projector shuts down and stays down. That is also what it was before any of this
    started.
    Operator's rule, now binding and recorded in docs/12-power-logic.md:
    Power on and power off send exactly ONE command each. If an action needs to do
    more, that belongs in the hub's automation or in a macro. Macros are the only
    thing that may send more than one command.
    Anything sent after the power key turns the projector back on — the OK lands on
    the next screen, and a second power key is simply a second toggle.
    WHAT BROKE IT
    1. 0b1a4a0 removed a verify-then-retry lo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
    [config.h, ecp.cpp, titan.cpp, titan.h]
2026-09-08 0.8.4-alpha: power off sends the power key twice — VERIFIED WORKING
    Full cycle from the SofaBaton activity, confirmed by the operator:
    [2956.376] TX 2A 2A 02 07 00 09 on, one frame
    [3086.243] TX 2A 2A 02 07 00 09 key 1 of 2 off
    [3088.246] TX 2A 2A 02 07 00 09 key 2 of 2 +2.003 s
    THE FIRST POWER KEY AFTER A POWER-ON IS SWALLOWED BY THE PROJECTOR. Proven with
    two byte-identical, acknowledged frames 91 s apart — the first ignored, the
    second raising the countdown:
    [178.905] TX 07 00 -> ACK 19 ms -> nothing happened
    [270.291] TX 07 00 -> ACK 32 ms -> countdown, projector off
    The original firmware sent it twice by accident: its verify-then-retry loop
    tested prob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
2026-09-10 0.9.0-beta: editable power sequences, in-app firmware install, persistent event log
    Promoted to beta. Power works reliably, the two things that made this project
    hard to debug are now instrumented, and the sequences that caused the trouble
    are editable from the app instead of compiled in.
    EDITABLE POWER SEQUENCES (Settings -> Power commands)
    Power on and power off each run a short script of literal serial frames, stored
    in NVS and editable from the app. What is stored is what is sent: no checksum
    correction, no added confirm key, no retry. The app shows the exact frames so
    they can be compared against XGIMI's reference, and "Reset to default" restores
    them exactly. Format is one frame per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
    [config.h, ecp.cpp, titan.cpp, titan.h, webui.h]
2026-09-10 docs: bring the README in line with what the project actually is now
    The adapter table said FTDI was the only class this projector binds, the power
    rows described sequences the firmware no longer sends, and serial-only was
    written as a future option when it is the build in daily use.
    - Adapters: OIKWAN USB→RS232 + MAX3232 confirmed as a second working class, and
    the one that is immune to back-powering by construction. PL2303TA listed as
    untested rather than implied broken.
    - Back-powering documented as its own section: the measurement (a dim LED on an
    unpowered ESP32), why the reverse direction matters more, and both fixes.
    - Power on/off described as what they are — power key ×1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
2026-09-10 Add MIT licence, trademark notice and warranty disclaimer
    MIT: permissive, attribution preserved via the copyright notice, and the
    shortest licence anyone will actually read. Copyright holder is the GitHub
    account rather than a personal name.
    Also states plainly what the README implied but never said: this is an
    independent clean-room implementation of Roku's ECP, built from public docs and
    observed behaviour. It is not a Roku device and contains no Roku software. XGIMI,
    Roku and SofaBaton marks are used only to describe interoperability.
    The warranty note is not boilerplate — this drives mains-powered hardware over an
    undocumented protocol whose parameters were established by probing, a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
2026-09-11 serial: self-test, UART recovery, and honest diagnosis when nothing answers
    Reported as "serial stops working after a period of time". Measured: 2,834
    frames out, 0 bytes in over 7.8 hours, heap flat, and boot #39 ran fine for 3.25
    hours before every command began failing and never recovered.
    /api/selftest loops UART1 back on itself and reports whether the ESP32 is
    driving the line. It passes — 6 bytes returned — so the UART, the pin routing
    and the frame parser all work, and the fault is off-board. Three separate
    investigations have now gone looking in this firmware for a fault that was never
    here; this endpoint answers that in one call.
    UART recovery: if the bridge has been transmitt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
    [config.h, ecp.cpp, titan.cpp, titan.h, webui.h]
2026-09-11 serial: lead with the remedy — the projector must re-enumerate the adapter
    Root cause of "serial stops working after a period of time": the projector is
    the USB host and had lost its binding to the adapter. After it power-cycles, if
    the adapter does not present a clean disconnect-then-reconnect, the host never
    re-runs enumeration and never re-binds ftdi_sio. The adapter sits powered but
    unbound, passing nothing — frames out, zero bytes in, not even line noise, for
    hours.
    Only a physical unplug and re-plug fixes it. Nothing this bridge can send
    triggers re-enumeration from the far end of a TTL cable. Confirmed: the operator
    re-plugged and the link came back immediately with a real temper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
    [webui.h]
2026-09-11 fix: back-powering does not apply to the MAX3232 build — retract that claim
    R-0005 and the test log both blamed back-powering as a contributing factor in
    the USB re-enumeration failure. That is wrong for the rig actually in use.
    The MAX3232 + OIKWAN build has no back-powering path by construction: the ESP32
    drives only the MAX3232, which is powered from the ESP32's own rail and is never
    unpowered, and the link from there to the adapter is RS232 — resistive receiver
    inputs, no diode path to VCC, rated to be driven while powered off. That is the
    whole reason this build was recommended.
    The claim was carried over from the direct-TTL FTDI wiring, where it is real and
    was measured. Correcte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
